guilinbai/iv-measurement/上位机/README.md

# 上位机软件（4 路 IV 测量）

> 本目录是**电脑端**软件。Arduino 固件在 `..\arduino测试\12\12.ino`。
> 当前进度：**第 3 期已完成**——三图界面（电压 / 电流 / **温度**），统一时间轴联动。
> 第 1 期：固件 v1.1 + 设备自检 + 采集核心；第 2 期：双图界面；
> 第 3 期：**TA612 温度采集 + Wanptek 电压源（MODBUS-RTU）控制**。

---

## 一、这台电脑的实测环境（已确认可用）

| 项目 | 实测结果 |
|---|---|
| Python | **3.11.9**（`C:\Users\guili\AppData\Local\Programs\Python\Python311`） |
| VISA | **NI-VISA 已装**（后端 `C:\Windows\system32\visa32.dll`） |
| pyvisa | 1.16.2 ✓ |
| pyserial / numpy / pyqtgraph / pandas / PyYAML | 均**已装** ✓ |
| **PySide6** | ❌ **未装**（界面要用，见下方安装命令） |
| Arduino IDE | 2.x（`C:\Program Files\Arduino IDE`），自带 arduino-cli 1.5.1 |

### 两台万用表（USB）

| 用途 | VISA 地址 | 序列号 | 固件 | 当前功能 |
|---|---|---|---|---|
| **测电压** | `USB0::0x05E6::0x6500::04587682::INSTR` | 04587682 | 1.7.12b | `VOLT:DC` |
| **测电流** | `USB0::0x05E6::0x6500::04468141::INSTR` | 04468141 | 1.0.04b | `CURR:DC` |

两台都在 **NPLC=1、自动调零开、电压量程 0.1 V、电流量程 10 µA** —— 正好适合小信号器件。

### 关键实测数据（决定时序参数）

| 指标 | 实测值 | 影响 |
|---|---|---|
| `:READ?` 耗时 | **约 21~25 ms**（自动量程下） | 但**自动调零每 5 次会到 43 ms**，自动量程切换时更慢 → 固件 `T_WINDOW=80 ms` 才安全 |
| 电压档本底噪声 | ±0.1 mV 波动 | 远优于 mV 级信号 ✓ |
| **电流档本底** | **±20~50 pA** | 比 10 µA 信号低 5 个数量级 ✓ 系统很干净 |
| 一轮 8 次测量 | **实测 1.80 s**（T_WINDOW=80） | 间隔 2 s 余量 **0.20 s（偏紧）**；建议 2.5 s |

### 串口

| 端口 | 设备 | 说明 |
|---|---|---|
| **COM9** | USB-SERIAL CH340 | **Arduino（开关阵列）** ✓ |
| COM11 | USB-SERIAL CH340 | 另一个 CH340 设备（不是 Arduino） |
| COM5 / COM6 | 蓝牙串口 | **不要探测**（Windows 打开会卡住，脚本已自动跳过） |
| COM1 | 主板串口 | 同上 |

> ⚠️ **CH340 没有序列号**，USB 重新插拔后端口号会反复变（实测见过 `COM7/COM9` → `COM9/COM11` → `COM12/COM13`）。
> **所以脚本里不要写死端口号**：程序会自动探测；烧录固件前也要先探测（见下方"端口总在变怎么办"）。
> 所以 `config.yaml` 里 `arduino.port` **建议留空**，由程序**自动探测**（发 PING，谁回应谁是 Arduino）。

---

## 二、安装依赖

```powershell
# 只缺界面库（其余都装好了）
pip install PySide6
```

> 如果以后换电脑，一次装齐：
> ```powershell
> pip install pyvisa pyserial numpy pandas PyYAML pyqtgraph PySide6
> ```
> 另外需装 **NI-VISA**（或 Keysight IO Libraries）才能用 USB 连万用表。

---

## 三、目录里的文件

| 文件 | 作用 | 状态 |
|---|---|---|
| `config.yaml` | 全部配置（设备地址、采样间隔、存储目录、时序参数） | ✅ 已按实测填好 |
| `check_devices.py` | **设备自检**：查两台表 + 找 Arduino + 实测耗时 | ✅ 实测 3.4 s |
| `main.py` | 采集主程序（命令行版：调度 + 双表读数 + 落盘） | ✅ 已实测跑通 |
| **`main_gui.py`** | **★ 图形界面**（双图 + 控制面板 + 实时状态） | ✅ **第 2 期** |
| `inspect_db.py` | 数据查看与筛选导出（`--runs` 看运行记录） | ✅ 可用 |
| `setup_github.py` | **一键配置 GitHub 备份**（配远程 + 测连通 + 推送） | ✅ 见 `17-备份到GitHub.md` |
| `ui/main_window.py` | 主窗口：控制区、状态栏、日志、间隔保护 | ✅ |
| `ui/plots.py` | 双图组件：X 轴联动、时间轴、降采样 | ✅ |
| `ui/buffer.py` | 内存环形缓冲 + 降采样 + 跨天历史查询 | ✅ |
| `ui/worker.py` | 采集线程（信号驱动，界面永不被阻塞）+ 模拟数据源 | ✅ |
| `ivcore/config.py` | 配置加载 + 一轮耗时/间隔保护计算 | ✅ |
| `ivcore/devices.py` | 硬件封装（Arduino 串口自动探测 + DMM6500） | ✅ |
| `ivcore/storage.py` | 存储（SQLite WAL + CSV 实时副本 + 分钟/小时聚合表） | ✅ |
| `ivcore/scheduler.py` | 采集调度（发 S → 收 WIN → 读表 → 落盘）+ 降采样 | ✅ |

---

## 四、使用步骤

### 第 1 步：上传 Arduino 固件 v1.1（[OK] 已完成，2026-10-30）

用 Arduino IDE 打开 `..\arduino测试\12\12.ino` 上传（板子选 **Arduino Nano**、处理器 **ATmega328P**、端口 **COM9**）。

> ⚠️ **上传前必须先关掉串口监视器**，否则报"拒绝访问"。

v1.1 相比 v1.0 新增：
- `S` 命令：扫一轮（4 路 × V+I = 8 项，按模式分组，耦合器只切 2 次）
- 每个读数窗口上报 `WIN <通道> <V|I>`（PC 收到立刻读表）
- 一轮结束报 `ROUND DONE`
- **看门狗**：10 秒没收到命令自动回安全态并报 `WATCHDOG`

### 第 2 步：跑设备自检

```powershell
cd D:\Ai_agent\deepseek-ha\test-system\上位机
python check_devices.py
```

正常输出应包含：两台 DMM6500、Arduino 在 COMxx、以及一轮耗时建议。

也可以分开查：

```powershell
python check_devices.py --idn      # 只查万用表
python check_devices.py --serial   # 只查串口
```

### 第 3 步：跑采集主程序（第 1 期核心）

> ⚠️ **运行前先关掉 Arduino IDE 的串口监视器**，否则报"打不开串口 COM9"。

```powershell
cd D:\Ai_agent\deepseek-ha\test-system\上位机

python main.py                 # 按 config.yaml 一直跑（Ctrl+C 停止）
python main.py --rounds 5      # 只跑 5 轮（先验证）
python main.py --duration 60   # 跑 60 秒
python main.py --interval 3    # 临时改成 3 秒间隔
python main.py --no-csv        # 不写 CSV 实时副本
python main.py --dry           # 不连硬件，用假数据验证存储链路
```

正常输出（实测）：

```
  [    1]  8/8  14:23:37 | lag -0.36s | V: -0.035 mV -0.065 mV 0.011 mV 0.041 mV   I: 0.06 nA 0.02 nA -0.04 nA 0.02 nA
  [    2]  8/8  14:23:39 | lag -0.42s | V: 0.057 mV 0.098 mV 0.037 mV 0.125 mV    I: 0.04 nA 0.03 nA 0.08 nA 0.02 nA
```

| 字段 | 含义 |
|---|---|
| `8/8` | 本轮采到的项数 / 应有项数 |
| `lag -0.36s` | 提前 0.36 s 完成（**负数=有余量**；变正数说明跟不上） |
| `V: ...` `I: ...` | 4 路电压 / 4 路电流的读数 |
| 收尾时 `[OK] 一致（N 行）` | CSV 实时副本与数据库行数一致（关闭时自动校验补齐） |

### 第 4 步：查看 / 导出数据

```powershell
python inspect_db.py                                  # 看最新一天的概况
python inspect_db.py --list                           # 列出所有天的数据库
python inspect_db.py --runs                           # ★ 看 runs 表（每次运行的时间 + 配置快照）
python inspect_db.py --export out.csv --ch 1,3 --mode V   # ★ 空通道在这里一次筛掉
python inspect_db.py --export wide.csv --wide         # 宽表（一行一轮，与实时副本同格式）
python inspect_db.py --export p.csv --from 14:00 --to 15:00
```

`--runs` 输出示例（能看到每次运行到底用了什么配置）：

```
  run_id = 3
     开始 : 2026-10-12 15:58:31
     结束 : 2026-10-12 15:58:42
     时长 : 10.6 秒
     配置 : 间隔=2.0 s   通道=4   T_WINDOW=50 ms
            dmm_voltage = USB0::0x05E6::0x6500::04587682::INSTR
            dmm_current = USB0::0x05E6::0x6500::04468141::INSTR
            存储目录: D:\IV_data
            本次命令行覆盖: {'rounds': 2}
            程序: main.py (CLI, phase-1)
```

也可以直接用图形工具打开数据库（推荐免费的 **DB Browser for SQLite**，官网 `sqlitebrowser.org`）：
打开 `D:\IV_data\2026-10-12\2026-10-12.db` → 选 **Browse Data** → 下拉框切表（`samples` / `runs` / `round_log` / `events` / `agg_1min` / `agg_1hour`）。

### 第 5 步：启动图形界面（第 2 期）

> ⚠️ 同样：**先关掉 Arduino IDE 的串口监视器**。

```powershell
python main_gui.py                 # 正常启动
python main_gui.py --fake          # 启动即进入模拟模式（不接硬件，看界面效果）
python main_gui.py --interval 5    # 覆盖采样间隔
```

界面布局与操作：

```
┌ [▶开始采集] [■停止] │ 采样间隔[2.00 s] │ 视图 (10分)(1时)(1天)(7天) │ [✓]跟随最新 │
│ 通道 [✓]ch1 [✓]ch2 [✓]ch3 [✓]ch4                              [ ]模拟模式 ┐
├ ✓ 一轮耗时 1.80 s ／ 间隔 2.50 s ／ 余量 0.70 s —— 可行                    ┤
│  电压 Voc（上）  ┐                                                         │
│                  ├ ← 两个图 X 轴联动（缩放/平移任一个，另一个同步）        │
│  电流 Isc（下）  ┘                                                         │
├ 状态：轮数/周期/余量/点数/时长/数据来源   │ 日志：连接、探测、事件        │
└────────────────────────────────────────────────────────────────────────────┘
```

| 功能 | 说明 |
|---|---|
| **双图共享时间轴** | 上图电压、下图电流；缩放/平移任意一个，另一个同步（垂直网格线始终对齐） |
| **四档视图** | 10 分钟 / 1 小时 → 内存缓冲；1 天 → `agg_1min`；7 天 → `agg_1hour`（秒出） |
| **跟随最新** | 自动滚动到最新；你一旦手动缩放/平移，会**自动取消跟随**（避免打架） |
| **通道开关** | 取消勾选即隐藏某路曲线（**不影响采集与存储**）—— 空通道的噪声点一下就没 |
| **间隔保护** | 实时计算"一轮耗时/间隔/余量"，不够时**红字警告** |
| **模拟模式** | 不连硬件生成假数据，用来预览界面、验证绘图性能。**注意：模拟模式只喂给界面看，不写数据库**（避免假数据混进真实数据） |
| **优雅退出** | 关窗时先让采集线程收尾（Arduino 回安全态 → 校验 CSV），最多等 15 秒 |

**实测性能**（这台电脑）：

| 指标 | 结果 |
|---|---|
| 降采样 100 万点 → 1600 点 | **18.6 ms** ← 绘图耗时与数据量无关的数学保证 |
| 界面刷新 | 3 Hz（可改 `ui.refresh_hz`） |
| 7 天视图查询 | 走 `agg_1hour` 只取约 168 点 → **毫秒级** |

自检用的无头截图模式（不需要显示器）：

```powershell
python main_gui.py --fake --screenshot preview.png --shot-seconds 25
```

---

## 五、config.yaml 怎么改

| 想要什么 | 改哪里 |
|---|---|
| 换数据存放位置 | `storage.dir` |
| 改采样间隔 | `acquisition.interval_s`（**最小 2.16 s** 比较稳；2.0 s 也行但余量只有 0.20 s） |
| 关闭"边测边写 CSV" | `storage.write_csv_realtime: false`（不推荐，会失去断电保护） |
| 手动指定 Arduino 端口 | `devices.arduino.port: ""`（**建议留空自动探测**，见下方"端口总在变"） |
| 调整读数精度/速度 | `devices.dmm_*.nplc`（小信号建议保持 1） |
| **量程策略** | `devices.dmm_*.autorange`（**默认 true = 自动量程**，见下方） |

### ⚠️ 量程策略（重要：不要锁死量程）

| 配置 | 行为 | 什么时候用 |
|---|---|---|
| **`autorange: true`（默认）** | 表自己选档位 | ✅ **正常用这个** |
| `autorange: false` + `range: 0.1` | 锁死在 100 mV 档 | ⚠️ **只有确认被测值一定在该档内**才用 |

**为什么不能锁死**：把电压表锁在 0.1 V 档后，一旦器件 Voc 超过 0.1 V（比如 1.5 V）就**超量程报错**，读数无效。电流表锁在 10 µA 档同理。

**自动量程的两个实测特性**（我已验证并据此调整参数）：

| 特性 | 实测 | 应对 |
|---|---|---|
| 信号稳定时**不切换档位** | 每次读数仍只要 21~25 ms | 无需额外代价 ✓ |
| **自动调零（AZER）每 5 次**多花约 20 ms | 周期性出现 41~43 ms | 固件 `T_WINDOW` 从 50 → **80 ms** |
| 量程切换时那一次较慢 | 可能 60~100 ms | **启动时预热 3 次**让档位先稳定（程序已自动做） |

日志里会显示实际量程，例如：
```
电压表: 已配置 func=VOLT:DC 量程=0.1(自动)
电压表: 预热 3 次，量程=0.1(自动)，单次 21~23 ms
```

### ⚠️ 间隔保护（程序会提示）

| 采样间隔 | 一轮 1.80 s 之后的余量 |
|---|---|
| **2.5 s（推荐）** | 0.70 s ✓ 舒服 |
| 2.0 s（你当前的设定） | **0.20 s** ⚠️ 可行但偏紧 |
| 1.8 s | ~0 s ✗ 临界 |
| < 1.8 s | 负 ✗ 跑不完 |
| **最小建议** | **2.16 s**（= 1.80 × 1.2） |

**想用 2.0 s 又想要更多余量**：把 `config.yaml` 的 `t_settle_ms` 从 80 降到 60（同时固件里 `T_SETTLE` 也要改并重新上传），一轮就降到 1.64 s，余量变 0.36 s。

程序会在间隔过小时红字警告（命令行/界面都会）。

---

## 六、常见问题

| 现象 | 原因 / 解决 |
|---|---|
| `[X] 打开 VISA 失败` | NI-VISA 没装，或万用表被其它软件占用（KickStart 等） |
| 只找到 1 台表 | 检查另一台 USB 是否插好；两台表的 USB 线别插在同一个 Hub 上尝试换口 |
| 串口无回应 | ① Arduino 被 IDE 的串口监视器占用 → 关掉；② 数据线是"只能充电"的线；③ 板子没插好 |
| 脚本输出中文乱码 | 用 **Windows Terminal** 或 **VS Code** 的终端运行；或在 cmd 里先执行 `chcp 65001` |
| 探测串口卡住很久 | 已修复：脚本现在**只探测 USB 串口芯片**，自动跳过蓝牙/主板串口 |
| **端口号又变了（如 COM9 → COM12）** | USB 重新枚举，CH340 端口号会变。**程序会自动探测，不用管**；但烧录固件时要先探测（见下） |

### 端口总在变怎么办（烧录固件时）

`arduino-cli` 需要显式指定端口，所以**不能写死**。先探测哪个口回应 PING：

```powershell
cd D:\Ai_agent\deepseek-ha\test-system\上位机
python check_devices.py --serial     # 会打印出"Arduino 在 COMxx"
```

然后烧录（把 `COMxx` 换成上面查到的）：

```powershell
& "C:\Program Files\Arduino IDE\resources\app\lib\backend\resources\arduino-cli.exe" `
    upload -p COMxx --fqbn arduino:avr:nano "D:\Ai_agent\deepseek-ha\test-system\arduino测试\12"
```

或者用 Arduino IDE 图形界面：**工具 → 端口** 里选那个 `COMxx` 再点上传。

> 💡 **想减少端口变化**：把 Nano 插到**主板后置 USB 口**（不要用 Hub、不要用前面板延长线）。实测插 Hub 上容易反复重编号。
| 上传固件报"拒绝访问" | 串口监视器占用 → 关掉再上传 |

---

## 八、第 3 期新增：温度采集与电压源控制

### 8.1 温度采集器（TA612，COM4）

**协议**（来自《TA系列通讯协议.docx》，已用真机 TA612 V3.50 验证）：

| 项 | 内容 |
|---|---|
| 串口 | 9600, 8N1 |
| 取型号/版本 | 发 `AA 55 00 03 02` → 回 `55 AA 00 07 64 02 5E 01 CB`（型号 0x0264=TA612，版本 V3.50） |
| 取实时温度 | 发 `AA 55 01 03 03` → 回 `55 AA 01 0B | ch1 | ch2 | ch3 | ch4 | Sum` |
| 数据换算 | 16bit 低字节在前，**温度 = 原始值 / 10**（℃） |
| 校验 | 从帧头起累加取低 8 位 |

实测：ch1 = ch2 = 26.7 ℃，**ch3/ch4 返回 28000**（未接探头的标志值，程序已自动过滤为 None）。
采集节奏独立于测量（`devices.tasensor.interval_s`，默认 5 秒）。

### 8.2 电压源（Wanptek，COM13，MODBUS-RTU）

**协议**（来自《通讯协议4_1.pdf》）：8N1、**波特率 2400**、**从站地址 0**（都是出厂默认）、数据小端、CRC16-MODBUS。

| 操作 | MODBUS 指令 | 地址 |
|---|---|---|
| 读状态/电压/电流 | `0x03` 读寄存器 | 0x0000 状态0, 0x0001 状态1, 0x0002 当前电压, 0x0003 当前电流, 0x0004 设置电压, 0x0005 设置电流, 0x0006 最大电压, 0x0007 最大电流 |
| 设电压 | `0x10` 写寄存器 | **0x0001**（值 = 电压 × 100） |
| 设限流 | `0x10` 写寄存器 | **0x0002**（值 = 电流 × 1000） |
| 输出开关 | `0x05` 写线圈 | **0x0000**（0xFF00=开 / 0x0000=关） |

实测本机电源：**31 V / 5.2 A**，初值 设定 10.690 V / 1.000 A、输出已开。

> ⚠️ **之前探测失败的原因**：我一直试 9600 bps + 地址 1，而设备默认是 **2400 bps + 地址 0**。
> 如果换电源，用 `python -m ivcore.powersupply COM13` 只读自测（不会改任何设置）。

**安全设计**：
- 超过设备最大电压（31 V）直接拒绝
- 退出程序**默认不关输出**（`off_on_exit: false`），避免打断控温实验
- 界面操作：`驱动电压源：[10.69] V  [应用]  [输出：开/关]  实测 0.000V/0.000A 设定 10.69V/1.000A 恒压`

### 8.3 界面：三个图共享时间轴

`
┌ 电压 Voc   4 条曲线 ┐
├ 电流 Isc   4 条曲线 ┤ ← X 轴联动（缩放/平移任一个，其余同步）
├ 温度 ℃     T1、T2   ┘   ch1 红 / ch2 蓝；两条线的**间距就是 ΔT**
`
状态栏还会直接显示 `T1=26.7  T2=26.7  ΔT=0.0 ℃`。
**温差会随驱动电压增大而拉大** —— 图上看两条线的间距即可。

### 8.4 数据文件新增

同一天目录下多一个 **`YYYY-MM-DD_env.csv`**（一行一次温度采样）：

`csv
iso_time,t1,t2,dt
2026-10-21 16:54:08,26.70,26.70,0.00
2026-10-21 16:54:13,26.80,26.60,0.20
`
- `t1`/`t2` = ch1/ch2 温度（℃）
- `dt` = **温差**（自动计算）
- 对应数据库表 `env(ts, run_id, sensor, ch, value, unit, quality)`
- 时间戳用 PC 时间（设备帧里没有时间戳），所以与测量数据天然共轴 ✅

---

## 七、数据格式（重要）

### 7.1 CSV 实时副本：**宽表，一行一轮**

```csv
iso_time,round_id,v1,i1,v2,i2,v3,i3,v4,i4
2026-10-12 15:56:25,1,-7.17045e-05,6.56688e-12,-0.000529928,-8.68163e-12,-0.00138152,5.5831e-12,-0.000532182,2.69802e-11
2026-10-12 15:56:27,2,3.11824e-05,7.62438e-12,-4.82313e-05,7.67346e-11,-3.42538e-05,4.9773e-11,1.07207e-06,2.92067e-12
2026-10-12 15:56:29,3,-6.8232e-05,...
```

| 列 | 含义 | 说明 |
|---|---|---|
| **iso_time** | 本轮的**网格时刻** | **只到秒**；**严格按采样间隔递增**（设 2 s 就每行差 2 s，设 5 s 就差 5 s）。它是 `t0 + n × 间隔` 算出来的，所以永不断档、永不等间隔失真 |
| **round_id** | 轮号 | 在**同一天内连续递增**，程序重启也不会重置 → 重启后的数据仍能按它排序 |
| **v1,i1,v2,i2,v3,i3,v4,i4** | 4 路的电压/电流 | 某路读失败 → 该格**留空**（不写 0，避免误判）；整轮失败 → 写一行空数据，**保证时间列不断档** |

> 💡 **时间列的两种含义**（都在 SQLite 里，溯源时可查）：
> - `iso_time`（CSV 里这一列）= **本轮网格时刻**，代表"这一轮是什么时候测的"，等间隔
> - `samples.ts`（只在数据库里）= 每个测量点的**物理精确时刻**，8 个点相差约 190 ms
>
> 你的器件在 7 天尺度上变化很慢，用网格时刻画图完全够，而且横轴天然均匀。

### 7.2 数据库里另外两列的含义（CSV 里没有，供追溯）

| 列 | 含义 | 用途 |
|---|---|---|
| **run_id** | 第几次"运行会话"——每启动一次 `main.py` 就是一个 run（1,2,3…） | 区分"这批数据是哪次连续采集的"；`runs` 表里还存了每 run 的**起止时间**和**当时的完整配置**（`config_json`），半年后能回答"当时参数是多少" |
| **quality** | 数据质量：`0`正常 / `1`可疑 / `2`无效 | 目前读数失败会记 `2`；后处理可 `WHERE quality=0` 一次滤掉坏点 |

### 7.3 存储结构

```
D:\IV_data\
└─ 2026-10-12\
   ├─ 2026-10-12.db              主存储（SQLite，WAL）
   │     samples    每个测量点一行（含精确 ts、grid_ts、run_id、quality）
   │     round_log  每轮一行（含空轮）→ 宽表可完整重建
   │     runs       每次运行的起止时间与配置快照
   │     events     事件日志（断线、重连、网格重对齐等）
   │     agg_1min / agg_1hour   多分辨率聚合表（画 1 天 / 7 天视图用）
   └─ 2026-10-12_samples.csv     实时副本（宽表，一行一轮）
```

- **命名零填充**（`2026-10-03` 而不是 `2026-10-3`）→ 按文件名排序 = 按时间排序 ✓
- **WAL 模式** → 断电不损坏，最多丢 1~2 秒
- **7 天数据量**：约 30 万行 / **~15 MB**（2 s 间隔、含温湿度；比长表省很多）
- **画图不卡**：多分辨率聚合表 + 按像素降采样 → 绘图耗时只跟屏幕宽度有关，与数据量无关

> ⚠️ **格式变过一次**：如果你的目录里有早期版本生成的 CSV（长表、毫秒时间戳），
> 建议删掉那个文件重跑 —— 新旧格式混在一个文件里会乱。
> 数据库会自动迁移（补 `grid_ts` 列），不用管。
> 第一次git修改尝试ing
