guilinbai/iv-measurement/1-测试系统目的与设计.md

# 多路并行 IV 测量系统 · 项目说明（文件一）

> **一句话**：用一台 Keithley DMM6500，轮询测量 16 路（可扩展）**彼此独立、浮空**的器件，记录每路的 **开路电压 Voc** 与 **短路电流 Isc**，连续运行 ≥7 天无人值守。
>
> **本包共 12 项（9 份文档 + 1 个固件 + 2 张图，图各含 svg/png）**：①本说明 ②CircuitJS 仿真·手动版（2 路教学） ③CircuitJS 仿真·Arduino 自动版（**4 路**） ④采购清单 ⑤面包板排线教程（14 只光耦逐脚接线表） ⑥单通道接线详图（svg+png） ⑦系统整体结构图（svg+png） ⑧面包板接线图画法（用 Fritzing 画实物接线图） ⑨PCB打板与四路板设计（含网表与布局图） ⑩四路板PCB布局图 ⑪Arduino入门与固件编写 ⑫固件-4路IV测量.ino

---

## 1. 目标与需求基线

| 项 | 指标 |
|---|---|
| 通道数 | 16 路起（PCB 与 595 链预留，可扩到 24/32） |
| 测量内容 | 每路 **Voc** 与 **Isc**，可选二选一或都测 |
| 器件量程 | Voc ≤ **2 V**（含小信号 **100 mV** 场景）；Isc ≤ **10 mA**（含 **10 µA** 场景） |
| 器件特性 | 彼此**独立、浮空**；允许长期短路、允许开路，不会损坏 |
| 连续运行 | **≥ 7 天**无人值守 |
| 采样间隔 | 几百 ms ~ 几百 s 任意可配 |
| 引线长度 | 器件 → 开关阵列 **≤ 1 m** |
| 预算 | 开关/继电器部分 **≤ 1000 元** |
| 装配约束 | **不会焊接** → 两阶段：面包板（直插） → 嘉立创 PCB + SMT 代贴 |
| 接线制式 | **两线制**（不用四线/开尔文）；汇总式**轮询**（非真并行） |
| 温度预留 | 本期不装，只留 4 针槽位（5V/GND/SDA/SCL + A0/A1） |

---

## 2. 测试逻辑（核心，不能做错的部分）

### 2.1 每个通道 3 只开关

器件两端各一只"选通开关"接到公共母线，另有一只"短接开关"直接并在器件两端：

```
   器件 A 端 ──┬──[ R_selA 选通 ]── 母线 HI ──┬──[ 模式耦合器 A ]── DMM 电流端口 ─┐
               │                              ├──[ 模式耦合器 V ]── DMM 电压端口 ─┤
               └──[ R_short 短接 ]──┐         │                                  │
                                    │         │                          DMM 公共端(黑)
   器件 B 端 ──┬─────────────────────┘         │                                  │
               └──[ R_selB 选通 ]── 母线 LO ───┴──────────────────────────────────┘

   · R_short 并在器件的 A、B 两端之间：闭合 = 器件被硬短接（0 V 工作点）
   · R_selA / R_selB 决定该器件是否接入母线 → 未选中器件与母线完全隔离
   · 全部开关用常开型 PhotoMOS（AQY272 / AQY212EH / AQY221R2V），LED 亮 = 导通，静音、长寿命
```

**为什么 B 侧开关不能省**：省掉 R_selB（让它常闭）就等于把 16 个器件的 B 端全部硬连在母线 LO 上——器件不再隔离。后果：①串扰漏电翻倍（未选中通道的漏电通路从 `2·R_off` 降到 `1·R_off`）；②16 路共地引入地环流与天线效应；③失去"A、B 双开关串联把关"的故障容错（R_selA 一旦短路失效，该器件会永久并联在母线上且无迹象）。只有"器件本来就共负端"时才可改单端复用（每通道 1 只开关）。

### 2.2 通道状态表

| 模式 | 状态 | 选通 A/B | 短接 | 器件看到什么 |
|---|---|---|---|---|
| Isc | 间隙 | 断开 | **导通** | 两端硬短接 |
| Isc | 过渡①：先断短接 | 断开 | 断开 | **开路**（升到 Voc） |
| Isc | 取样 | **导通** | 断开 | 电流表（近零 burden） |
| Isc | 过渡②：先离表 | 断开 | 断开 | **开路** |
| Voc | 间隙 / 取样前 | 断开 | 断开 | 开路 |
| Voc | 取样 | **导通** | 断开 | 电压表（高阻） |
| **安全态（上电/掉线/看门狗）** | — | 断开 | **导通** | 隔离 + 短接 |
| 整机掉电 | — | 断开 | 断开 | 开路（无驱动） |

### 2.3 切换时序：**先断短接，再合选通**（break-before-make）

```
测 Isc(ch)：                                   测 Voc(ch)：
 ① 断开短接（器件开路 → Voc）                   ① 断开短接（确保不短接）
 ② 等待 t_open（10~50 ms）                      ② 等待 t_open
 ③ 合选通 A/B（接入电流表）                     ③ 合选通 A/B（接入电压表）
 ④ 等待 settle_time（★50~100 ms）               ④ 等待 settle_time
 ⑤ 读 Isc                                       ⑤ 读 Voc
 ⑥ 断选通 A/B（先离表）                         ⑥ 断选通 A/B
 ⑦ 等待 t_open                                  ⑦ 合短接（回间隙态）
 ⑧ 合短接（回间隙态）
```

**为什么这样**：任何时刻"短接通路"与"测量通路"**绝不同时导通** → 表计读到的电流**不含分流成分**，是器件完整的 Isc（原"先合后断"方案会有短接开关并联分流的瞬间）。

**代价与配套**：器件接表前后各有一次短暂开路，接表瞬间有放电瞬态（τ ≈ R_burden × C_器件）→ `settle_time` 取 **50~100 ms** 起步，按器件电容实测缩短。前提是器件允许开路。

### 2.4 三条关键电气约定

1. **未选中通道保持短接（钳位 0 V）**：这是抑制串扰的关键——器件被短接后 Voc 被钳到 0 V，不再向母线注入电压，串扰只剩纯漏电阻分流。任何时刻只有被选中通道的短接开关断开。
2. **表 burden 要小**：burden 是漏电误差的乘数。用 DMM6500 低电流量程（反馈式电流计）；若要把 10 µA 测得更准，可加一级跨阻放大器（TIA，虚地 → 漏电影响趋近 0）。
3. **漏电门槛**（针对小信号器件，详见 2.5）：**直插型号 ≥60 MΩ（≤1 µA @60 V）刚好达标；推荐 ≥600 MΩ（≤100 nA）**。

### 2.5 漏电流预算速查（小信号器件的选型依据）

**先折算再比较**——datasheet 漏电是在**额定电压**下规定的：

```
AQY272：10 µA @ 60 V  →  R_off = 60 V ÷ 10 µA = 6 MΩ
器件工作电压只有 100 mV →  实际漏电 = 100 mV ÷ 6 MΩ ≈ 17 nA（不是 10 µA！）
器件模型：Rs = Voc ÷ Isc = 100 mV ÷ 10 µA = 10 kΩ
```

| 误差来源（N=16，15 路未选中） | 公式 | AQY272(6 MΩ) | AQY212EH(60 MΩ) |
|---|---|---|---|
| 短接开关漏电并在器件两端（测 Voc） | Voc·Rs/(Rs+R_off) | −1.7% | **−0.17%** |
| 短接开关漏电分走 Isc（burden 10 mV） | V_b/R_off | 1.7 nA | **0.17 nA** |
| 未选中通道短接时的串扰（burden 100 mV） | V_b(N−1)/(2R_off) | 1.25% | **0.125%** |
| 未选中通道开路时注入 Voc 差（ΔVoc=100 mV） | ΔVoc·Rs/(Rs+2R_off/(N−1)) | 1.23% | **0.125%** |

**反推门槛**（目标：漏电误差 ≤ 0.1% × 10 µA = 10 nA）：`R_off ≥ 7.5×10⁸ × V_b`
→ burden 10 mV 需 ≥7.5 MΩ；burden 100 mV 需 ≥75 MΩ。
→ **门槛 ≤1 µA @60 V，推荐 ≤100 nA**（留 10 倍余量）。

> 注意：PhotoMOS 关断漏电**随温度上升**（可能翻数倍）。7 天连续测试要按最高工作温度算。

---

## 3. 测试模式与调度

| 模式 | 行为 | 表功能切换 |
|---|---|---|
| `isc_only` | 每轮只测 Isc | 一次都不用切 |
| `voc_only` | 每轮只测 Voc | 一次都不用切 |
| `both` | 每轮先 Isc 后 Voc（同一通道连测），或按轮次交替 | 每通道切一次，需等表稳定 |

**调度规则**：
- 一轮扫描 = 依次测完所有**启用**的通道；**整轮间隔**由一个共用计时器控制（启用 4 路就扫 4 路，间隔仍是设定值）；
- 相邻两路取样窗口**不重叠**（同一时刻只有一个器件接在母线上）；
- `both` 模式的**轮间间隙态 = 短接**（不长期开路）；
- 采样间隔可配：几百 ms ~ 几百 s。

**模式切换顺序**（`both` 模式或分时段计划，整轮层面执行一次）：
① 所有通道回间隙态 → ② 先断当前模式耦合器 → ③ 切 DMM 功能（`SENS:FUNC "CURR"`/`"VOLT"`）+ 量程/NPLC → ④ 再合新耦合器 → ⑤ 等 50~100 ms → 继续扫描。

---

## 4. 硬件方式

### 4.1 总体架构

```
 ┌── 被测器件 1..16（彼此独立、浮空，两线引出，双绞线 ≤1 m）──┐
 │                                                              │
 │   每通道 3 只常开 PhotoMOS（2 选通 + 1 短接）                │
 │        ↑ LED 驱动（各串 1 kΩ 限流电阻）                      │
 └────────┴─────────────────────────────────────────────────────┘
          │
 ┌────────┴─────────┐
 │ 控制链（与测量侧光学隔离，不共地）                        │
 │  Arduino Nano ── SPI(3 线) ── 74HC595 ×4（32 位锁存）     │
 │  每通道 2 位：选通位（驱动 A、B 两只）、短接位             │
 │  串口 115200 接 PC；看门狗 10 s 无指令 → 写入安全态       │
 └──────────────────┘
          │
 ┌────────┴─────────┐
 │ 测量侧（浮空，不接控制地）                                │
 │  母线 HI ──┬─ 模式耦合器 A ── DMM 电流端口（1 Ω 级 burden）│
 │            └─ 模式耦合器 V ── DMM 电压端口（≥10 GΩ）      │
 │  母线 LO ─────────────────── DMM 公共端（黑，INPUT LO）   │
 └──────────────────┘
```

### 4.2 控制链要点

- **每通道 2 个控制位**：选通位（同时驱动 A、B 两只光耦的 LED，各串 1 kΩ）、短接位；
- **4 路原型**：Nano 直驱 → 用 **D2~D11 共 10 个数字输出**（4 路 × 2 位 + 2 只模式耦合器），不需要 595；完整逐脚接线见《5-面包板排线教程.md》；
- **16 路正式板**：32 位 → **4 片 74HC595 级联，只占 3 个引脚**（`D10`=数据 DS、`D11`=移位时钟 SHCP、`D12`=锁存 STCP）。若直驱则需 32 个引脚，而 Nano 可用数字输出只有 16 个（D2~D13 + A0~A3）→ **不够，必须用 595**；
- ⚠️ **引脚坑**：`A6/A7` **只能作模拟输入**，不能配置为数字输出 → 不可用于驱动光耦 LED；`D0/D1` 留给串口；`A4/A5` 预留给温度（I2C）；
- **固件原子执行整段时序**：PC 只发高层命令（`PING / ALL_SAFE / MEAS ch mode / RESTORE ch mode / READBACK`），不逐位控制，防止 PC 卡顿导致器件悬空；
- **看门狗 10 s**：无指令 → 写入安全态（选通全断、短接全合）；
- 上电第一条指令即写入安全态；整机掉电时 595 无输出 → 全断开 = 器件开路（已接受此代价）；
- 电源：5 V/1 A 适配器；48 只 LED 全亮约 144 mA + Nano 30 mA，裕量充足。

### 4.3 万用表三端口与模式耦合器

| DMM 端子 | 接法 |
|---|---|
| **公共端（黑，INPUT LO）** | 母线 LO（电流档与电压档**共用**） |
| **电流端口** | 经**模式耦合器 A** 接母线 HI |
| **电压端口** | 经**模式耦合器 V** 接母线 HI |

> ⚠️ **互锁必做**：两个模式耦合器**绝不可同时闭合**（电流端口约 1 Ω 会把电压端口旁路，电压读数立即失效）。**推荐一只 SPDT 耦合器**（公共端接母线 HI、两掷位分别接电流/电压端口），物理上不可能同时接通；若用两只独立开关，必须固件互锁 + 硬件联锁。

### 4.4 两阶段实施

| 阶段 | 做法 | 目的 |
|---|---|---|
| ① 面包板（4 路） | 直插 **AQY212EH ×14**（12 通道 + 2 模式耦合器）+ Arduino Nano + 面包板 ×3，**零焊接**；逐脚接线见《5-面包板排线教程.md》 | 验证时序、固件、上位机流程与接线 |
| ② 正式板（16 路） | 嘉立创 PCB 打样 + SMT 代贴 AQY221R2V ×48 + 排母插 Nano | 小信号精度、7 天连续运行 |

### 4.5 接线与屏蔽

- 器件 → 开关 ≤1 m：**24 AWG 双绞线**（或网线成对取用），A 端红、B 端黑，每通道挂线标；
- 开关 → DMM：母线两线双绞引出；
- 端子排按 ch1→ch16 排列（左 A 右 B，防插错）；
- ≤1 m 下无需屏蔽；有强干扰源时母线改屏蔽双绞线，屏蔽层浮接 DMM 大地端子。

---

## 5. 已定决策与陷阱速查

### 5.1 已定决策

| 议题 | 结论 |
|---|---|
| 开关类型 | 全 **常开 PhotoMOS**（全固态、静音、统一型号），短接靠**主动驱动** |
| 间隙态 | Isc 模式 = **短接**（兼作串扰钳位）；Voc 间隙 = 开路 |
| 切换顺序 | **先断短接 → 再合选通**（break-before-make） |
| 掉电行为 | 开路（不再"掉电即短接"，已接受） |
| 故障安全 | **固件看门狗主动维持短接态**（必须做） |
| 接线制式 | 两线制；轮询；不用四线/开尔文 |
| 器件短路 | 可长期短路不受损 → 无需常态化短接 |

### 5.2 陷阱速查（都踩过）

| # | 陷阱 | 要点 |
|---|---|---|
| 1 | **AQY212EH vs AQY212EHA** | Package 都写 DIP4，但 `EHA` 是**贴片鸥翼**；**不带 A 后缀的 `EH` 才是直插**。下单前看手册 "Terminal Type" |
| 2 | **低漏电只有贴片** | nA 级（RF/低 C×R 系列）只有 SSOP/SOP；直插 DIP-4 通用型是 µA 级（1 µA） |
| 3 | **漏电不能直接比** | datasheet 漏电在额定电压下规定，要按实际工作电压折算（见 2.5） |
| 4 | **两个模式耦合器同时闭合** | 1 Ω 旁路 10 MΩ → 电压读数失效；用 SPDT 或做互锁 |
| 5 | **CircuitJS：控制端位置** | 模拟开关控制端由"**吸附到网格后的引线中点**"算出 → **元件中点必须落在 16 的整数倍上**，否则控制线接不上（表现为 `bad connections`、开关恒断开） |
| 6 | **CircuitJS：电压源极性** | **第 2 个点才是正端**（`getVoltageDiff()` = volts[1]−volts[0]）；接反了控制端会变成 0/−5 V，低于 2.5 V 阈值 → 开关永不导通 |
| 7 | **B 侧开关不能省** | 见 2.1（串扰翻倍、共地环流、失去故障容错） |

---

## 6. 本包使用方法

### 6.0 先看两张图（比文字快）

| 图纸 | 看什么 | 格式 |
|---|---|---|
| **6-单通道接线详图** | 一个通道怎么接：**1kΩ 限流电阻接在光耦 1 脚与 Arduino 引脚之间**、2 脚接控制侧 GND、3/4 脚接器件与母线；以及"为什么仿真图里看不到 1kΩ" | `.svg`（矢量，可无限放大）+ `.png`（直接看） |
| **7-系统整体结构图** | 4 路整体结构：14 只光耦的分工（通道1~4 + 模式耦合器）、母线 HI/LO 的汇集、模式耦合器与万用表三端口、控制侧与测量侧的隔离边界 | `.svg` + `.png` |

> ⚠️ **仿真图与真实电路的一处重要差异**：CircuitJS 的"模拟开关"是**理想电压控制开关**（控制端只判电压、不耗电流），所以仿真里**画不出 LED 侧**，也就没有 14 只 1kΩ 限流电阻。真实电路必须有（每只光耦 1 脚各一只），详见第 6 图。

### 6.1 打开仿真文件（文件二 / 文件三）

1. 浏览器打开 **https://www.falstad.com/circuit/circuitjs.html**
2. 菜单 **File → Import From Text**，把 `.txt` 全部内容粘进去，确定
3. 点 **RUN** 开始仿真；`View → Zoom Out` 可看全图（4 路版图较高，需多缩几档）
4. 读电流：鼠标**停在 1 Ω 取样电阻上不动**，信息框显示 `I`

| 文件 | 特点 |
|---|---|
| **文件二（手动版）** | **2 个器件**、手动开关（教学用，开关少好操作），用来**看懂"先断短接→再合选通"的顺序** |
| **文件三（Arduino 自动版）** | **4 路**，周期 1 秒、每路一个 250 ms 时间槽；8 个方波源模拟 D2~D9 引脚输出，自动循环；含万用表三端口与两个模式耦合器（手动开关） |

### 6.2 文件三的操作要点

- **4 路时间槽**：ch1 `[0~0.25s]`、ch2 `[0.25~0.5s]`、ch3 `[0.5~0.75s]`、ch4 `[0.75~1.0s]`，每路测量窗口 **125 ms**，互不重叠；
- 各通道器件模型不同（便于区分读数）：ch1 = 1.5 V/150 Ω（≈9.9 mA）、ch2 = 1.2 V/240 Ω（≈5.0 mA）、ch3 = 1.0 V/100 Ω（≈9.8 mA）、ch4 = 0.6 V/300 Ω（≈2.0 mA）；
- 默认状态 = **电流模式**（模式耦合器 A 闭合、V 断开）→ 悬停 1 Ω 看 Isc；
- 测 **Voc**：**先点开**模式耦合器 A，**再点合**模式耦合器 V → 悬停 10 MΩ 看电压；
- 验证"信号纯净"：悬停各开关，会发现**没有任何时刻"选通=闭合"且"短接=闭合"**；
- 图上标注的 **光耦1 ~ 光耦14** 与《5-面包板排线教程.md》的编号**完全一致**，可对照验证接线。

### 6.3 下一步

1. 面包板按阶段①搭起来，跑通固件 + 上位机流程；
2. 用 DMM6500 **实测**关断漏电（加 100 mV、LED 不加电、电流档串测）→ 用它校正 2.5 的预算；
3. 固件把 2.3 的时序表实现为状态机；上位机按 3 的模式与调度写采集循环；
4. 正式板 layout（16 路 × 3 只 + 4 片 595 + SPDT 模式耦合器）→ 嘉立创打样 + SMT。
