guilinbai/iv-measurement/11-Arduino入门与固件编写.md

# Arduino Nano 入门与固件编写（零基础版）

> 目标：让你从"没用过 Arduino"到"能自己改代码、能让引脚输出脉冲、能跑通 4 路测量时序"。
> 配套固件：**《12-固件-4路IV测量.ino》**（可直接打开上传）。

---

## 一、先搞懂一件事：什么叫"控制信号脉冲"

Arduino 的一个数字引脚，**只有两种状态**：

| 状态 | 电压 | 代码 |
|---|---|---|
| 高电平 HIGH | 5 V | `digitalWrite(引脚, HIGH);` |
| 低电平 LOW | 0 V | `digitalWrite(引脚, LOW);` |

**"脉冲"就是：拉高 → 保持一段时间 → 拉低。** 就这么简单：

```cpp
digitalWrite(2, HIGH);   // ① 拉高（5V）
delay(100);              // ② 保持 100 毫秒
digitalWrite(2, LOW);    // ③ 拉低（0V）
delay(100);              // ④ 保持 100 毫秒，然后循环 → 就形成连续脉冲
```

上面 4 行在 D2 上产生的就是**周期 200 ms 的方波**（高 100 ms、低 100 ms），也就是"1 秒 5 个脉冲"。

### 我们的"时序"是什么

我们的时序 = **多个引脚，在不同时刻，各自产生不同长度的脉冲**：

```
D3（短接）  ────┐                    ┌──────────────
                └────────────────────┘
D2（选通）  ─────────┐          ┌──────────────────
                     └──────────┘
             ①断开   ②合上   ③保持   ④断开   ⑤合上
             T_OPEN  T_SETTLE T_DWELL  T_OFF
```

对应代码就是依次写 5 条语句（`measureIsc()` 函数）：

| 步骤 | 代码 | 含义 |
|---|---|---|
| ① 断开短接 | `digitalWrite(PIN_SHORT[ch], LOW);` | 器件脱离短接，开路 |
| 等 30 ms | `delay(T_OPEN);` | 让器件升到 Voc |
| ② 合上选通 | `digitalWrite(PIN_SEL[ch], HIGH);` | 器件接上万用表 |
| 等 80 ms | `delay(T_SETTLE);` | 等瞬态衰减、表稳定 |
| ③ 保持读数 | `delay(T_DWELL);` | 万用表在这 60 ms 内取值 |
| ④ 断开选通 | `digitalWrite(PIN_SEL[ch], LOW);` | 器件离表 |
| 等 20 ms | `delay(T_OFF);` | 确保不同时导通 |
| ⑤ 合上短接 | `digitalWrite(PIN_SHORT[ch], HIGH);` | 回到间隙态 |

**所以"控制信号脉冲"= 引脚电平 + `delay()` 时长。** 你要改时序，就改那几个时间常数（`T_OPEN` / `T_SETTLE` / `T_DWELL` / `T_OFF`），不用改逻辑。

### 为什么不用 PWM（analogWrite）

`analogWrite()` 输出的是**快速开关的 PWM**（约 490 Hz 方波，用来调 LED 亮度/电机转速）。我们需要的是"**慢慢地接通、断开一个开关**"，所以用 `digitalWrite()` ✓

### 精度说明（够用就行）

| 需求 | 用什么 |
|---|---|
| 毫秒级（我们的场景：几十毫秒） | `delay(ms)` ✅ 足够 |
| 微秒级 | `delayMicroseconds(us)` |
| 更精确/非阻塞 | `micros()` 轮询计时，或定时器中断 |

> `delay()` 会"卡住"程序（阻塞）。我们的时序里每个窗口几十毫秒，完全够用；等以后要同时做别的事，再改成 `micros()` 非阻塞写法。

---

## 二、准备工作（一次性的，约 20 分钟）

### 2.1 装 Arduino IDE

1. 打开 `arduino.cc/en/software`
2. 下载 **Arduino IDE**（Windows 版，约 200 MB）
3. 一路下一步装完

### 2.2 插上 Nano、装驱动

1. 用 **USB 数据线**（不是只能充电的线！）把 Nano 插到电脑；
2. 打开**设备管理器**看"端口 (COM 和 LPT)"：
   - 出现 `USB-SERIAL CH340 (COMx)` → ✅ 驱动已就绪，记住这个 **COMx**；
   - 出现带黄色感叹号的"未知设备" → 需要装 CH340 驱动：搜 **`CH341SER`**（沁恒官网）下载安装，或让 Windows 自动更新驱动；
   - 什么都没有 → 换一根数据线（十有八九是线的问题，不是板的问题）。

### 2.3 IDE 里选对板子和端口（**新手最容易卡在这里**）

| 菜单 | 选什么 |
|---|---|
| 工具 → 开发板 | **Arduino AVR Boards → Arduino Nano** |
| 工具 → 处理器 | **ATmega328P**；如果上传报错，改选 **ATmega328P (Old Bootloader)** ← 国产 CH340 板常见 |
| 工具 → 端口 | 选那个 **COMx**（可以拔插一次 Nano，看哪个端口消失又出现） |

---

## 三、第一次上传：让板载 LED 闪起来

**第 1 步**：把下面代码粘进 IDE，点左上角"→"上传：

```cpp
void setup() {
  pinMode(LED_BUILTIN, OUTPUT);      // Nano 板载 LED 在 D13
}
void loop() {
  digitalWrite(LED_BUILTIN, HIGH);   // 亮
  delay(500);
  digitalWrite(LED_BUILTIN, LOW);    // 灭
  delay(500);
}
```

**看到什么算成功**：
- IDE 底部显示 `上传完成`；
- Nano 板上一颗小 LED **每 0.5 秒闪一次** ✅

> 上传失败最常见的原因：处理器没选 `Old Bootloader`、端口选错、USB 线是充电线。

**第 2 步（练习脉冲）**：把 `LED_BUILTIN` 换成 `2`，然后在面包板上接一个 LED 试：

```
Nano D2 ──[1kΩ]── LED 长脚(＋) ── LED 短脚(－) ── Nano GND
```

改一下 `delay()` 的数值（比如 100 / 100），你会看到 LED 闪得快慢变化 —— **这就是"改脉冲宽度"**，也正是我们时序里 `T_SETTLE` 那种参数的意义。

---

## 四、上传我们的 4 路固件

1. 用 Arduino IDE 打开 **《12-固件-4路IV测量.ino》**；
2. 确认板子/处理器/端口选好 → 点上传；
3. 上传成功后，打开 **工具 → 串口监视器**，右下角波特率选 **115200**；
4. 你会看到：

```
==========================================
 4 路 IV 测量控制器  v1.0
 命令: a=自动  i1..i4=测Isc  v1..v4=测Voc
       c=电流模式  u=电压模式  s=安全态
==========================================
当前: 安全态 + 电流模式。输入 a 开始自动循环。
```

### 用串口命令测试（特别适合刚开始调试）

在串口监视器的输入框里敲字符 + 回车：

| 命令 | 作用 | 你会看到 |
|---|---|---|
| `i1` | 手动测一次通道 1 的 Isc | 光耦-3 先灭 → 光耦-1、光耦-2 亮 → 再反过来 |
| `v1` | 手动测一次通道 1 的 Voc | 同上（先确认 `u` 切到电压模式） |
| `a` | 开始/停止自动循环 | 4 路依次动作，停不下来就再按一次 `a` |
| `c` / `u` | 切电流/电压模式 | 光耦-13 亮 或 光耦-14 亮（**绝不同时亮**） |
| `s` | 立刻回安全态 | 4 只短接光耦全亮、选通全灭 |

> **看 LED 就能验证时序对不对**：如果某个时刻"选通"和"短接"用的光耦同时亮着 → 时序错了（这是本项目最关键的检查点）。

---

## 五、和上位机（Python）怎么配合

固件负责"按时序拨开关"，PC 上的 Python 负责"读万用表"，两者用**串口**对齐节奏：

```
PC(Python+pyvisa)                        Nano(固件)
   │  发 "i1"  ─────────────────────────▶│
   │                                      │ ①断短接、②合选通…③保持窗口
   │  读串口直到出现 "WINDOW CH1"  ◀──────│ 在窗口开始时打印一行
   │  此刻万用表已经在读 → 取值            │
   │  取完发 "s"（或继续下一路）─────────▶│ ④断选通、⑤合短接
```

**你现在的阶段**：先用串口命令手动跑通、用 LED 目视确认时序；
**下一阶段**：把 `T_DWELL` 改成"打印 `WINDOW CHn` 后等一下"，PC 端读到这行就读表 —— 这样就不依赖精确的绝对时间。

---

## 六、常见坑（新手基本都会踩一遍）

| # | 现象 | 原因 / 解决 |
|---|---|---|
| 1 | 端口列表里没有 COMx | USB 线是"充电线"（换线）；或没装 CH340 驱动 |
| 2 | 上传报错 `avrdude: stk500_getsync()` | 处理器选项改成 **ATmega328P (Old Bootloader)** |
| 3 | 上传报错 `port busy` | 关掉串口监视器再上传（串口被占用） |
| 4 | 上传成功但没反应 | 端口/板子选错，传到了别的设备；或 LED 接反（长脚是＋） |
| 5 | **`A6`/`A7` 接光耦不动作** | **A6/A7 只能做模拟输入，不能做数字输出**，换 D2~D13 或 A0~A3 |
| 6 | 引脚发烫 / 板子重启 | 单脚电流别超 20 mA（我们的 LED 约 3.75 mA，安全）；所有引脚合计别超 200 mA |
| 7 | LED 一直亮不闪 | 代码没上传成功，或该引脚被别的程序占用 |
| 8 | 光耦不导通 | 光耦 **1、2 脚接反**（1=阳极、2=阴极）；或限流电阻没串对 |
| 9 | 时序看起来对但表读数不对 | 检查地线：控制侧 GND 与测量侧母线 LO **绝不能相连** |

---

## 六.5 实战速查：这台电脑上实测定位过的上传问题

> 实测环境：Arduino IDE 2.x + arduino-cli **1.5.1** + `arduino:avr` **1.8.8** + CH340 驱动 **3.9.2024.9** + Nano 在 **COM9**。

| 报错原文 | 真正原因 | 解决 |
|---|---|---|
| `cannot open port \\.\COM9: 拒绝访问`<br>`unable to open port COM9 for programmer` | **串口监视器独占了端口**（进程名 `serial-monitor`） | **关掉串口监视器再上传**。命令行也可确认/释放：`Get-Process serial-monitor \| Stop-Process -Force` |
| `not in sync: resp=0x00`<br>`programmer is not responding` | **处理器选项选错**（误选了 Old Bootloader）；或 CH340 克隆板**自动复位偶发失效** | 处理器选 **ATmega328P**（**不是** Old Bootloader）；失败就**重试 1~2 次**；仍失败则"点上传后立刻按一下板上 RESET 键" |
| IDE 提示 sketch 名无效 / 无法创建文件夹 | **sketch 名含中文**——Arduino 只允许字母、数字、下划线、连字符 | 用纯英文名（如 `arduino测试\13\13.ino`）；中文名的 .ino 删掉重建 |

**本机验证可用的上传配置**（照这个选，一次成功）：

| 项 | 值 |
|---|---|
| 开发板 | **Arduino Nano** |
| 处理器 | **ATmega328P** ← 不是 Old Bootloader |
| 端口 | **COM9**（USB-SERIAL CH340） |
| 操作顺序 | ① 关串口监视器 → ② 点上传 → ③ 传完再开监视器 |

> 💡 **两条铁律**（本项目尤其重要，因为你要一边看串口一边量万用表）：
> 1. **串口监视器开着 = 无法上传**（报"拒绝访问"）；
> 2. **每次改完代码上传前，先关监视器**。

---

## 七、测电压最容易误会的一件事：光耦 1 脚只有 1.1 V

接好光耦后，很多人会拿万用表去量"D2 有没有输出 5 V"，结果在**光耦 1 脚**上量到 **1.0~1.3 V**，以为板子坏了。**其实完全正常。**

### 各点的正常读数

| 表笔位置 | 正常读数 | 含义 |
|---|---|---|
| **Nano 的 D2 引脚本身**（或电阻靠 D2 的那一端） | **≈ 5.0 V** | 这才是引脚的输出电压 |
| 电阻另一端 = **光耦 1 脚（LED 阳极）** | **1.0 ~ 1.3 V** | LED 的正向压降 Vf |
| 光耦 2 脚 / GND 蓝轨 | 0 V | 参考地 |

### 为什么？限流电阻就是"吃掉多余的电压"

```
  5.0 V ──[ 1 kΩ ]── 1.1 V ──[ 红外 LED ]── 0 V
   (D2)      ↑           ↑
         吃掉 3.9 V   LED 只需要 1.1 V

  电流 = 3.9 V ÷ 1 kΩ ≈ 3.9 mA   ← 正是设计值（3.75 mA 附近）✓
```

**反过来说：如果你在光耦 1 脚量到 5 V，那才说明有问题**——LED 回路没通、没有电流、光耦不会导通（常见原因：1/2 脚接反、LED 虚接、电阻没插到位）。

### 真正该做的验证（3 步）

| 步骤 | 怎么做 | 正常结果 |
|---|---|---|
| ① 验引脚 | 表笔戳 **D2 引脚本身**，黑笔接蓝轨 | ≈ 5.0 V |
| ② 验 LED | 表笔跨在 **光耦 1 脚与 2 脚**之间 | 1.0~1.3 V |
| ③ **验光耦有没有真的导通**（最关键） | 万用表切**电阻档/通断档**，测**光耦的 3、4 脚**：串口敲 `i1` 再敲 `s` | `i1` 时导通（几 Ω~几十 Ω，蜂鸣响）；`s` 时开路（OL） |

> 第 ③ 步才是真正证明"LED 亮 → 输出侧导通"这条链路通了。**只看 LED 亮不亮不够**（LED 亮但输出侧没接对，照样测不到东西）。

### 如果 D2 引脚本身（空载）也只有 1.1 V，那才需要排查

| # | 检查项 | 怎么查 |
|---|---|---|
| 1 | 固件传进去了吗 | 串口监视器（115200）能否看到启动横幅；敲 `a` 有没有反应 |
| 2 | 引脚认错了吗 | 面包板上 Nano 的引脚极易差一格。用**通断档**确认"D2 那个孔"和"Nano 的 D2 脚"是同一网络 |
| 3 | 5 V 本身正常吗 | 量 Nano 的 5V 引脚对 GND：应 4.9~5.1 V；不足则是 USB 线/口的问题 |
| 4 | 引脚被烧过吗 | 之前若直接短路或灌过大电流可能损坏。换 D12 试（固件里把 `PIN_SEL[0]` 改成 12），若 D12 正常说明 D2 坏了，弃用它 |
| 5 | 引脚是浮空态吗 | 只有 `pinMode(pin, OUTPUT)` 之后 `digitalWrite` 才真正驱动；固件里已设置，但如果你在跑自己的测试代码，先检查这一句 |
| 6 | **HIGH 时只有 1~2 V（LOW 正常）** | 这是"引脚高边驱动损坏"或"测点上仍挂负载"的典型症状。诊断三步：① 直接戳 **Nano 排针本身**（绕开面包板）——若是 5 V，问题在面包板/接线；② 检查代码有没有误用 `analogWrite()`（PWM 平均值会造成低压假象）；③ **改固件换一个空闲引脚**（如把 `PIN_SEL[0]` 从 2 改成 12）对比——新引脚正常即可断定原引脚已损坏 |
| 7 | 引脚怎么会被烧坏 | ① 引脚**直接短接 5V/GND**（没串电阻）；② LED **没串限流电阻**；③ 带电插拔；④ 静电。预防：**接线前先拔 USB**、LED 必串 1 kΩ、绝不把引脚直接连到电源轨 |
| 8 | **忘记 `pinMode(pin, OUTPUT)`（最高频的坑）** | 引脚默认是**输入（高阻）**。此时 `digitalWrite(pin, HIGH)` 不是"输出 5 V"，而是**接通约 20~50 kΩ 的内部上拉**，只能给约 0.1 mA，带不动任何负载。**真实案例**：只写了 `pinMode(LED_BUILTIN, OUTPUT)` 却对 D2 做 `digitalWrite`，结果在光耦 1 脚量到 **1.08 V**（= 红外 LED 在上拉微弱电流下的正向压降）、LOW 时量到 0.07 V。**这个读数恰恰证明"回路是通的、LED 正向导通、只是电流太小"，引脚并没有坏**——加上 `pinMode(2, OUTPUT);` 后 HIGH 立刻变成 5 V |

---

## 八、想改什么，改哪里

| 你想做的事 | 改哪里 |
|---|---|
| 调整等待时间（器件/表不同） | `T_OPEN` / `T_SETTLE` / `T_DWELL` / `T_OFF` 四个常量 |
| 调整整轮间隔（采样周期） | `T_INTERVAL`
| 只做 2 路 | 把循环上限 `4` 改成 `2`，并把 `PIN_*` 数组只留前两个 |
| 扩到 8 路 | `PIN_SEL` / `PIN_SHORT` 各加 4 个引脚（8 路需要 16 个引脚 → 得用 74HC595，见文件九 §3） |
| 默认用电压模式 | `setup()` 里把 `switchMode(true)` 改成 `switchMode(false)` |
| 加温度传感器 | 用 A4/A5（I2C），读 SHT31/DS18B20 后一起从串口输出 |

---

## 八、一句话总结

> **脉冲 = `digitalWrite(HIGH)` + `delay(一段时间)` + `digitalWrite(LOW)`。**
> 我们的"测量时序"就是把这 5 步按顺序写出来；你只要改那几个 `T_*` 时间常数就能调快调慢。
> 上传流程：装 IDE → 装 CH340 驱动 → 选 Nano + ATmega328P(Old Bootloader) + COMx → 点上传 → 串口监视器 115200 看日志。
