guilinbai/iv-measurement/5-面包板排线教程.md

# 面包板排线教程（4 路原型 · 零焊接）

> 对应仿真文件《3-仿真图-Arduino自动版.txt》里的元件编号。**照着本表逐根接线即可，不需要看懂电路。**
> 需要：Arduino Nano ×1、AQY212EH 光耦 ×**14**、1 kΩ 电阻 ×**14**、830 孔面包板 ×**3**、杜邦线若干、KF301-2P 端子 ×4。
>
> 📐 **配套图纸**（先看图再看表，效率最高）：
> - 《**6-单通道接线详图.svg**》→ 一个通道怎么接，特别是 **1kΩ 限流电阻**接在哪（这是仿真图里看不到的部分）
> - 《**7-系统整体结构图.svg**》→ 4 路的整体结构、14 只光耦的分工、母线与万用表三端口的连接

---

## 0. 一分钟看懂整体结构

```
   板1（控制侧）        板2（光耦区）              板3（测量侧）
  ┌──────────────┐   ┌────────────────────┐   ┌──────────────────────┐
  │ Arduino Nano │   │ 14 只光耦 + 14 只  │   │ 红轨 = 母线 HI       │
  │  5V/GND 电源轨│──▶│ 1kΩ 电阻           │──▶│ 蓝轨 = 母线 LO       │
  │              │   │                    │   │ 4 个器件端子 ch1~ch4 │
  └──────────────┘   └────────────────────┘   └──────────────────────┘
       D2~D11 ─────────┘  （10 根控制线 + 1 根 GND）
                          每只光耦的 3/4 脚 ──▶ 板3 的器件端子与母线
```

**为什么分成 3 块板**：控制侧（板1+板2 的 LED 回路）与测量侧（板2 的输出侧 + 板3）**不共地**，光耦是唯一的跨接桥梁——这正是真实系统的隔离方式。板 2 的蓝轨只做**控制侧 GND**，绝不能接到板 3 的蓝轨（母线 LO）。

---

## 1. 光耦编号规则

**编号 = 通道顺序 × 3 + 用途**，与仿真图上的标注一一对应：

| 光耦编号 | 用途 | 位置（面包板上） | 仿真图标注 |
|---|---|---|---|
| **光耦-1** | 通道1 选通 A（器件A端 ↔ 母线HI） | 板2 | 光耦1（选通A1） |
| **光耦-2** | 通道1 选通 B（器件B端 ↔ 母线LO） | 板2 | 光耦2（选通B1） |
| **光耦-3** | 通道1 短接（器件A端 ↔ 器件B端） | 板2 | 光耦3（短接1） |
| **光耦-4** | 通道2 选通 A | 板2 | 光耦4（选通A2） |
| **光耦-5** | 通道2 选通 B | 板2 | 光耦5（选通B2） |
| **光耦-6** | 通道2 短接 | 板2 | 光耦6（短接2） |
| **光耦-7** | 通道3 选通 A | 板2 | 光耦7（选通A3） |
| **光耦-8** | 通道3 选通 B | 板2 | 光耦8（选通B3） |
| **光耦-9** | 通道3 短接 | 板2 | 光耦9（短接3） |
| **光耦-10** | 通道4 选通 A | 板2 | 光耦10（选通A4） |
| **光耦-11** | 通道4 选通 B | 板2 | 光耦11（选通B4） |
| **光耦-12** | 通道4 短接 | 板2 | 光耦12（短接4） |
| **光耦-13** | **模式耦合器·电流**（母线HI ↔ DMM电流端口） | 板2 | 光耦13（模式·电流） |
| **光耦-14** | **模式耦合器·电压**（母线HI ↔ DMM电压端口） | 板2 | 光耦14（模式·电压） |

**总数 = 4 路 × 3 只 + 2 只模式耦合器 = 14 只** ✓

---

## 2. 每只光耦的 4 个引脚定义（AQY212EH / AQY272 都是 DIP-4，定义相同）

| 引脚 | 名称 | 属于哪一侧 | 接到什么 |
|---|---|---|---|
| **1 脚** | LED 阳极 | **控制侧** | 经一只 1 kΩ 电阻 → Arduino 数字引脚 |
| **2 脚** | LED 阴极 | **控制侧** | 控制侧 GND（板2 蓝轨） |
| **3 脚** | 输出端 | **测量侧** | 见第 3 节表格 |
| **4 脚** | 输出端 | **测量侧** | 见第 3 节表格 |

> **3、4 脚无极性**，可以互换（表里按"3 接器件侧、4 接母线侧"的惯例写，便于检查）。
> **1、2 脚不能接反**：1 脚是阳极（长脚/靠缺口标记），反接不亮。

---

## 3. 完整接线总表（14 只 × 4 脚 = 56 行）

**限流电阻命名**：R1~R14 分别串在光耦-1 ~ 光耦-14 的 1 脚上（每只光耦一个，**不要两只共用一个电阻**）。

### 通道 1（光耦-1 / 2 / 3）

| 光耦·引脚 | 用途 | 接到哪里 |
|---|---|---|
| 光耦-1-1 | ch1 选通A · LED阳极 | 经 **R1(1kΩ)** → Arduino **D2** |
| 光耦-1-2 | LED阴极 | 控制侧 GND（板2 蓝轨） |
| **光耦-1-3** | 输出 | **ch1 器件 A 端子** |
| **光耦-1-4** | 输出 | **母线 HI**（板3 红轨） |
| 光耦-2-1 | ch1 选通B · LED阳极 | 经 **R2(1kΩ)** → Arduino **D2**（与光耦-1 同一引脚） |
| 光耦-2-2 | LED阴极 | 控制侧 GND（板2 蓝轨） |
| **光耦-2-3** | 输出 | **ch1 器件 B 端子** |
| **光耦-2-4** | 输出 | **母线 LO**（板3 蓝轨） |
| 光耦-3-1 | ch1 短接 · LED阳极 | 经 **R3(1kΩ)** → Arduino **D3** |
| 光耦-3-2 | LED阴极 | 控制侧 GND（板2 蓝轨） |
| **光耦-3-3** | 输出 | **ch1 器件 A 端子**（与光耦-1-3 同一点） |
| **光耦-3-4** | 输出 | **ch1 器件 B 端子**（与光耦-2-3 同一点） |

### 通道 2（光耦-4 / 5 / 6）

| 光耦·引脚 | 用途 | 接到哪里 |
|---|---|---|
| 光耦-4-1 | ch2 选通A · LED阳极 | 经 **R4(1kΩ)** → Arduino **D4** |
| 光耦-4-2 | LED阴极 | 控制侧 GND（板2 蓝轨） |
| **光耦-4-3** | 输出 | **ch2 器件 A 端子** |
| **光耦-4-4** | 输出 | **母线 HI**（板3 红轨） |
| 光耦-5-1 | ch2 选通B · LED阳极 | 经 **R5(1kΩ)** → Arduino **D4**（与光耦-4 同一引脚） |
| 光耦-5-2 | LED阴极 | 控制侧 GND（板2 蓝轨） |
| **光耦-5-3** | 输出 | **ch2 器件 B 端子** |
| **光耦-5-4** | 输出 | **母线 LO**（板3 蓝轨） |
| 光耦-6-1 | ch2 短接 · LED阳极 | 经 **R6(1kΩ)** → Arduino **D5** |
| 光耦-6-2 | LED阴极 | 控制侧 GND（板2 蓝轨） |
| **光耦-6-3** | 输出 | **ch2 器件 A 端子**（与光耦-4-3 同一点） |
| **光耦-6-4** | 输出 | **ch2 器件 B 端子**（与光耦-5-3 同一点） |

### 通道 3（光耦-7 / 8 / 9）

| 光耦·引脚 | 用途 | 接到哪里 |
|---|---|---|
| 光耦-7-1 | ch3 选通A · LED阳极 | 经 **R7(1kΩ)** → Arduino **D6** |
| 光耦-7-2 | LED阴极 | 控制侧 GND（板2 蓝轨） |
| **光耦-7-3** | 输出 | **ch3 器件 A 端子** |
| **光耦-7-4** | 输出 | **母线 HI**（板3 红轨） |
| 光耦-8-1 | ch3 选通B · LED阳极 | 经 **R8(1kΩ)** → Arduino **D6**（与光耦-7 同一引脚） |
| 光耦-8-2 | LED阴极 | 控制侧 GND（板2 蓝轨） |
| **光耦-8-3** | 输出 | **ch3 器件 B 端子** |
| **光耦-8-4** | 输出 | **母线 LO**（板3 蓝轨） |
| 光耦-9-1 | ch3 短接 · LED阳极 | 经 **R9(1kΩ)** → Arduino **D7** |
| 光耦-9-2 | LED阴极 | 控制侧 GND（板2 蓝轨） |
| **光耦-9-3** | 输出 | **ch3 器件 A 端子**（与光耦-7-3 同一点） |
| **光耦-9-4** | 输出 | **ch3 器件 B 端子**（与光耦-8-3 同一点） |

### 通道 4（光耦-10 / 11 / 12）

| 光耦·引脚 | 用途 | 接到哪里 |
|---|---|---|
| 光耦-10-1 | ch4 选通A · LED阳极 | 经 **R10(1kΩ)** → Arduino **D8** |
| 光耦-10-2 | LED阴极 | 控制侧 GND（板2 蓝轨） |
| **光耦-10-3** | 输出 | **ch4 器件 A 端子** |
| **光耦-10-4** | 输出 | **母线 HI**（板3 红轨） |
| 光耦-11-1 | ch4 选通B · LED阳极 | 经 **R11(1kΩ)** → Arduino **D8**（与光耦-10 同一引脚） |
| 光耦-11-2 | LED阴极 | 控制侧 GND（板2 蓝轨） |
| **光耦-11-3** | 输出 | **ch4 器件 B 端子** |
| **光耦-11-4** | 输出 | **母线 LO**（板3 蓝轨） |
| 光耦-12-1 | ch4 短接 · LED阳极 | 经 **R12(1kΩ)** → Arduino **D9** |
| 光耦-12-2 | LED阴极 | 控制侧 GND（板2 蓝轨） |
| **光耦-12-3** | 输出 | **ch4 器件 A 端子**（与光耦-10-3 同一点） |
| **光耦-12-4** | 输出 | **ch4 器件 B 端子**（与光耦-11-3 同一点） |

### 模式耦合器（光耦-13 / 14）

| 光耦·引脚 | 用途 | 接到哪里 |
|---|---|---|
| 光耦-13-1 | 电流模式 · LED阳极 | 经 **R13(1kΩ)** → Arduino **D10** |
| 光耦-13-2 | LED阴极 | 控制侧 GND（板2 蓝轨） |
| **光耦-13-3** | 输出 | **母线 HI**（板3 红轨） |
| **光耦-13-4** | 输出 | **DMM 电流端口**（红表笔 / 香蕉插座） |
| 光耦-14-1 | 电压模式 · LED阳极 | 经 **R14(1kΩ)** → Arduino **D11** |
| 光耦-14-2 | LED阴极 | 控制侧 GND（板2 蓝轨） |
| **光耦-14-3** | 输出 | **母线 HI**（与光耦-13-3 同一点） |
| **光耦-14-4** | 输出 | **DMM 电压端口** |

> ⚠️ **互锁铁律**：固件里 **D10 与 D11 绝不可同时为 HIGH**（1 Ω 电流档会把 10 MΩ 电压档旁路，电压读数立刻失效）。默认状态：**D10 = HIGH（电流模式）**、**D11 = LOW**。

---

## 4. Arduino Nano 引脚表（每个引脚的用途）

| 引脚 | 本项目的用途 | 接到哪里 |
|---|---|---|
| **D0 (RX)** | 串口接收 | USB 转串口，**不接外部** |
| **D1 (TX)** | 串口发送 | USB 转串口，**不接外部** |
| **D2** | ch1 选通（驱动 2 只 LED） | 经 R1→光耦-1-1，经 R2→光耦-2-1 |
| **D3** | ch1 短接 | 经 R3→光耦-3-1 |
| **D4** | ch2 选通 | 经 R4→光耦-4-1，经 R5→光耦-5-1 |
| **D5** | ch2 短接 | 经 R6→光耦-6-1 |
| **D6** | ch3 选通 | 经 R7→光耦-7-1，经 R8→光耦-8-1 |
| **D7** | ch3 短接 | 经 R9→光耦-9-1 |
| **D8** | ch4 选通 | 经 R10→光耦-10-1，经 R11→光耦-11-1 |
| **D9** | ch4 短接 | 经 R12→光耦-12-1 |
| **D10** | 模式耦合器·**电流**（默认 HIGH） | 经 R13→光耦-13-1 |
| **D11** | 模式耦合器·**电压**（默认 LOW） | 经 R14→光耦-14-1 |
| D12 | 空闲备用 | — |
| D13 | 空闲备用（板载 LED） | — |
| A0 ~ A3 | 空闲备用（可作数字 I/O） | — |
| **A4 (SDA)** | 温度传感器预留 | 本期不接 |
| **A5 (SCL)** | 温度传感器预留 | 本期不接 |
| **A6 / A7** | ⚠️ **只能作模拟输入** | 不能用于驱动光耦 |
| **5V** | 逻辑电源 | 板1 红轨（+5 V）——**4 路原型里红轨是空的／备用**，见下方说明 |
| **GND** | 逻辑地 | 板1/板2 蓝轨（**控制侧 GND**）——**这根必不可少** |
| **VIN** | 外部 7~12 V 输入 | 不用（走 USB 或 5V 脚供电） |
| **3V3** | 3.3 V 输出 | 不用 |
| **AREF / RESET** | 参考电压 / 复位 | 不用 |

**引脚占用小结**：4 路共 **10 个数字输出**（D2~D11），剩下 D12/D13/A0~A3 备用，A4/A5 留给温度 ✓

> **⚠️ 5V 红轨在 4 路原型里是空的，这是正常的**：光耦的 LED 由 **Arduino 引脚直接驱动**（引脚 HIGH=5V → 经 1kΩ → 光耦 1 脚 → 光耦 2 脚 → GND），**电流不经过 5V 轨**。
> - **必须接的只有蓝轨（GND）**：Nano GND → 板1 蓝轨 → 一根跳线跨到板2 蓝轨 → 板2 上 14 只光耦的 2 脚。缺这根线光耦一只都不亮。
> - **红轨留着备用**：接一个电源指示灯（LED + 1kΩ 跨在红蓝轨之间）能一眼看出通没通电；以后 74HC595 的 VCC、温度传感器也从它取电。
> - **绝不要改成"红轨 + 引脚拉低"（灌电流）接法**：那会让逻辑反过来（引脚 LOW 才导通），与固件和安全态完全相反。

**电流核对**：每只 LED 约 3.75 mA（1 kΩ 从 5 V：(5−1.25)/1000）；一个选通脚驱动 2 只 = 7.5 mA ✓（ATmega 单脚推荐 ≤20 mA）；间隙态 4 路短接位同时导通 = 4 × 3.75 ≈ 15 mA ✓ 5 V/1 A 电源裕量充足。

---

## 5. 测量侧接线表（板3）

| 测量侧节点 | 从哪来 | 去哪 |
|---|---|---|
| **母线 HI**（板3 红轨） | 光耦-1-4、光耦-4-4、光耦-7-4、光耦-10-4、光耦-13-3、光耦-14-3 | → 光耦-13/14 的输出侧，经模式耦合器到 DMM |
| **母线 LO**（板3 蓝轨） | 光耦-2-4、光耦-5-4、光耦-8-4、光耦-11-4 | → **DMM 公共端（黑）** |
| ch1 器件端子（KF301-2P） | A 脚 ← 光耦-1-3 + 光耦-3-3；B 脚 ← 光耦-2-3 + 光耦-3-4 | → 被测器件1 |
| ch2 器件端子 | A ← 光耦-4-3 + 光耦-6-3；B ← 光耦-5-3 + 光耦-6-4 | → 被测器件2 |
| ch3 器件端子 | A ← 光耦-7-3 + 光耦-9-3；B ← 光耦-8-3 + 光耦-9-4 | → 被测器件3 |
| ch4 器件端子 | A ← 光耦-10-3 + 光耦-12-3；B ← 光耦-11-3 + 光耦-12-4 | → 被测器件4 |
| **DMM 电流端口** | ← 光耦-13-4 | 接 DMM6500 电流输入（红） |
| **DMM 电压端口** | ← 光耦-14-4 | 接 DMM6500 电压输入（红） |
| **DMM 公共端（黑）** | ← 母线 LO | 接 DMM6500 INPUT LO |

**器件引线**：每个器件两根线（A 红 / B 黑），用 **24 AWG 双绞线**（或网线成对取用），长度 ≤1 m，两端挂线标 `ch1-A / ch1-B`…

**关于 KF301-2P 端子（为什么每通道要一个）**：它是一个**绿色小塑料块 + 两颗螺丝**的接线柱，背面两根金属针（间距 5.08mm，正好跨面包板 2 个孔，可直接插）。

- **怎么接**：器件 A 端线剥皮插左边孔、B 端线插右边孔 → **拧紧螺丝压住**，不需要焊接；
- **为什么要它**：① 你不会焊接，这是唯一不焊的器件接法；② 器件要换（扩路/换样品）时拧松即可；③ 螺钉压紧比面包板簧片可靠，适合 7 天连续运行；④ A/B 分左右两孔，防插错；
- **在哪**：面包板方案里 4 个插在板 3；PCB 方案里就是 J2~J5。

---

## 6. 建议的搭建顺序（按这个顺序不容易返工）

| 步骤 | 做什么 | 检查点 |
|---|---|---|
| ① | 板1 插上 Nano，红轨接 5V、蓝轨接 GND，插上 USB 供电 | 板载电源灯亮 |
| ② | 板2 按"光耦-1 到光耦-14"从左到右插好，**统一缺口朝向左边** | 14 只位置对齐，1 脚都在左 |
| ③ | 板2 插 14 只 1 kΩ 电阻（每只光耦的 1 脚各一只） | 电阻不共用 |
| ④ | 接 10 根控制线（板1 D2~D11 → 板2 各电阻 → 光耦 1 脚） | 用不同颜色杜邦线，按 D2~D11 顺序 |
| ⑤ | 把 14 只光耦的 **2 脚**统一接到板2 蓝轨（控制侧 GND） | 用一根跳线做"2 脚公共轨"更整洁 |
| ⑥ | 板3 红轨当母线 HI、蓝轨当母线 LO；把 4 只选通A光耦的 4 脚 → 红轨，4 只选通B光耦的 4 脚 → 蓝轨 | 逐一核对，别接反（A→HI、B→LO） |
| ⑦ | 4 个器件端子插到板3，按第 5 节把器件 A/B 线接好 | 每通道 4 根线（1-3、2-3、3-3、3-4） |
| ⑧ | 模式耦合器：光耦-13/14 的 3 脚 → 母线 HI，4 脚 → DMM 电流/电压端口 | 见第 3 节表 |
| ⑨ | 母线 LO → DMM 公共端；DMM 电流/电压端口线接好 | 三条 DMM 线就位 |

**排线美观小技巧**：控制线（板1→板2）全部走面包板上方、测量线（板2→板3）全部走下方，两类线不要捆在一起——既好查线，也减少串扰。

---

## 7. 上电前检查清单（务必逐条过）

| # | 检查项 | 正确状态 |
|---|---|---|
| 1 | 光耦 1、2 脚有没有接反 | 1 脚经电阻到 D 引脚，2 脚到控制侧 GND |
| 2 | 每个光耦的 1 脚是不是**各自**有一只 1 kΩ | 不允许两只共用一个电阻 |
| 3 | 控制侧 GND 与测量侧母线 LO 是否**意外短接** | **必须开路**（用万用表量：应为无穷大） |
| 4 | 光耦 3、4 脚有没有接到控制侧 | 3/4 脚只在测量侧 |
| 5 | 母线 HI 与母线 LO 之间量电阻 | 电流模式下经 1 Ω 取样电阻读到约 1 Ω（真实 DMM 内阻更小，接近短路） |
| 6 | D10 与 D11 是否同时为 HIGH | 固件上电必须 `D10=HIGH, D11=LOW`，且做互锁 |
| 7 | 器件端子有没有接错通道 | ch1~ch4 线标一致 |

---

## 8. 上电自检（不用万用表也能验）

1. **上电瞬间**：固件应把所有短接位拉高 → 14 只光耦里 4 只短接光耦 + 1 只模式耦合器亮（约 5 只 LED）；
2. **让固件执行"测一次 ch1"**：会看到 **光耦-3（短接1）先灭** → 然后 **光耦-1、光耦-2 同时亮** → 再反过来（先灭 1、2，再亮 3）。**如果看到"1、2 和 3 同时亮"，说明时序反了**，对照《1-测试系统目的与设计.md》§2.3 检查固件；
3. **依次测 ch2/ch3/ch4**：同样只应有对应的 2 只选通光耦亮起；
4. **切到电压模式**：光耦-13 灭、光耦-14 亮（两者绝不同时亮）；
5. 确认无误后再接被测器件和万用表。

---

*本教程与《1-测试系统目的与设计.md》配套；仿真对照见《3-仿真图-Arduino自动版.txt》。*
