guilinbai/iv-measurement/8-面包板接线图画法.md

# 面包板接线图画法（工具与步骤）

> 需求：**只要能把"实物怎么插线"画清楚，不需要仿真电流。**
> 结论：用 **Fritzing**（免费离线，面包板视图是它的招牌）。不想装软件就用 **breadboard 照片 + 画线**，零学习成本。

---

## 1. 先把工具分成两类（你要的是左边这类）

| | 画图连线类（← 你要的） | 仿真类（不需要） |
|---|---|---|
| 工具 | **Fritzing**、Tinkercad Circuits、draw.io + 面包板照片、CRUMB | CircuitJS、Proteus、Wokwi、EveryCircuit |
| 画出来 | **面包板 + 元件本体 + 彩色跳线**（实物风格） | 原理图符号 + 波形 |
| 会不会仿真 | 不会（也不影响用） | 会 |

> ⚠️ **CircuitJS / Proteus / KiCad 都画不出"实物样子"**——它们只画符号。所以之前我那几张 SVG 你看着抽象，是因为它们本质是"符号级"的图。**要实物感，必须用 Fritzing 这一类。**

---

## 2. 首选：Fritzing

### 2.1 它为什么正好合适

- 一个电路有 **面包板视图 / 原理图视图 / PCB 视图** 三种，**你在面包板视图里拖，图就是实物样子**；
- 面包板是**真的分区**（红蓝电源轨、中间隔离槽、63 列孔）；
- 跳线是**可以弯曲、可以改颜色**的曲线，跟杜邦线一样；
- **DIP 元件可以自定义引脚数** → 建一个 4 脚 IC 就是"光耦"；
- 画完可导出 PNG，**打印 A3 贴在工作台上照着插**。

### 2.2 下载与版本

| 渠道 | 说明 |
|---|---|
| 官网 fritzing.org/download | 现在是"自愿付费"（最低约 €8），付了会收到下载链接 |
| GitHub 源码自行编译 | 免费（需要一点动手能力） |
| 网上流传的 0.9.3b 旧版 | 免费，功能对本项目完全够用（面包板视图早就有） |

### 2.3 从零画这张图（约 30~40 分钟）

**第 1 步：建 14 只"光耦"元件**
1. 在 **面包板视图** 里，从右侧元件库 `MISC` → 拖入 **Generic IC**；
2. 双击它 → 引脚数填 **4**、封装选 **DIP**、名字填 `Opto-1`；
3. 重复或复制粘贴，做出 `Opto-1` ~ `Opto-14`（分别对应排线教程里的编号）。

**第 2 步：摆元件（照下表）**

| 板 | 放什么 | 摆放要点 |
|---|---|---|
| 板 1 | Arduino Nano ×1 | 跨中间槽，占 15 列；红轨接 5V、蓝轨接 GND |
| 板 2 | `Opto-1`~`Opto-14` ×14 | **横排**，每只跨中间槽占 2 列，间隔 1 列（共用约 42 列，一块 830 孔板能放下） |
| 板 2 | 1 kΩ 电阻 ×14 | 每只光耦旁边**竖插**一只（4 孔高） |
| 板 3 | 2P 螺钉端子 ×4 | 一排 4 个，做器件 A/B 端子 |
| 板 3 | 香蕉插座 ×2 | 接万用表的电流/电压端口 |

**第 3 步：连线（颜色按这个习惯，方便查线）**

| 线 | 颜色 | 从 | 到 |
|---|---|---|---|
| 控制线 ×10 | 蓝 | Nano 的 D2~D11 | 各电阻一端（每路一只电阻） |
| 电阻另一端 | 蓝 | 电阻另一端 | 光耦 **1 脚** |
| 光耦 2 脚 | 绿 | 全部 14 只的 2 脚 | 板 2 蓝轨（**控制侧 GND**） |
| 电源 | 红/黑 | 板 1 红轨/蓝轨 | Nano 5V / GND |
| **母线 HI** | **红** | 4 只"选通A光耦"的 4 脚 + 光耦13/14 的 3 脚 | 板 3 的母线 HI |
| **母线 LO** | **黑** | 4 只"选通B光耦"的 4 脚 | 板 3 的母线 LO → 万用表公共端 |
| 器件 A/B 线 ×8 | 黄/橙 | 光耦 3/4 脚 | 4 个 2P 端子 |
| 光耦13/14 输出 | 紫 | 光耦13-4 / 光耦14-4 | 香蕉插座（万用表电流/电压端口） |

> 每根线连到哪，**完整表格见《5-面包板排线教程.md》第 3 节**（14 只 × 4 脚 = 56 行），照着抄就行。

**第 4 步：导出**
`File → Export → as Image → PNG`，选高分辨率；打印时选 A3、横向。

### 2.4 偷懒技巧

先把 **1 只光耦 + 1 只电阻 + 3 根跳线**摆好连好，然后**框选整组复制 14 次**，再逐组只改"跳线的目标引脚"——比从零画快得多。

---

## 3. 不想装软件？三个零/低成本替代

### 3.1 面包板照片 + 画线（最"实物"，零学习成本）⭐

1. 买回面包板后**拍一张俯视照片**（或从网上找一张同型号的空板照片）；
2. 用 **Windows 画图 / PPT / Snipaste / draw.io** 打开照片；
3. 直接在照片上：**贴元件图片**（光耦、电阻、Nano 的实物照片）+ **画彩色曲线**当跳线；
4. 存成 PNG 打印。

**优点**：100% 是实物，不需要任何元件库。
**缺点**：手工活儿，改线要重画。

### 3.2 Tinkercad Circuits（在线免费）

- 网址 `tinkercad.com/circuits`，注册即用，**不用装任何东西**；
- 元件是 3D 实物外观，面包板分区真实，连线简单；
- **只要画图不点运行就行**（它带仿真，但你不点就没关系）；
- 缺点：元件库没有"光耦"，可以用"继电器"或"光耦(如果有)"替代；画的图不便导出高分辨率。

### 3.3 draw.io / diagrams.net（在线免费）

- 有电子元件符号库，但偏**原理图符号**，不是实物外观；
- 适合"在面包板照片上叠加连线"（配合 3.1 用）。

---

## 4. 画完这张图你能得到什么

| 用途 | 好处 |
|---|---|
| 打印出来放工作台 | 插线时**不用再翻文档**，逐根对 |
| 查线/排错 | 哪根线该在哪，一眼可见（比读表格快得多） |
| 改版 | 以后扩到 8 路/16 路，在图上加一组即可 |
| 交接 | 别人拿着图就能复现你的接线 |

---

## 5. 一句话总结

> **要实物感、要能连线、不要仿真 → 装 Fritzing（面包板视图）。**
> 不想装软件 → **拍张面包板照片，在照片上用画图软件贴元件、画跳线。**
> 仿真类的工具（CircuitJS / Wokwi / Proteus）解决的是"电路对不对"，不是"手怎么插"，本项目已经用 CircuitJS 验证过时序，剩下要的就是一张**给手看的图**。

---

## 6. 如果你也不想自己画

告诉我"**帮我出实物接线图**"，我可以按《5-面包板排线教程.md》的 56 行表，直接画一张**面包板实物风格**的图（画成有孔的板子 + 元件本体 + 彩色跳线，而不是电气符号），你核对后就能打印。
