guilinbai/iv-measurement/9-PCB打板与四路板设计.md

# PCB 打板与四路测量板设计

---

## 一、什么是"PCB 打板"

**PCB** = Printed Circuit Board，印制电路板。**"打板"**就是把你在电脑上画好的电路板文件交给工厂，让他们把板子**生产出来**。

### 完整流程（5 步）

```
① 画原理图      在 EDA 软件里把"哪个引脚连哪个引脚"画出来（= 我们的网表）
② 转 PCB 布局   元件摆到板子上的实际位置（位置、间距、接口朝向）
③ 布线          用铜线把该连的连起来（走线宽度、间距、过孔、覆铜）
④ 导出 Gerber   一套描述"每层长什么样"的标准文件（工厂只认这个）
⑤ 下单生产      选板厚/颜色/工艺 → 工厂开料、钻孔、曝光、蚀刻、丝印、喷锡、成型
```

### 和面包板的区别

| | 面包板 | PCB 打板 |
|---|---|---|
| 连接方式 | 插孔簧片 | **焊接**（或 SMT 代贴） |
| 可靠性 | 接触电阻会变、会松动 | 焊死，**适合 7 天连续运行** |
| 体积 | 大 | 小（4 路可做到 100×80 mm 以内） |
| 成本 | 面包板 ~10 元，可反复用 | 打样 5 片约 **5~30 元**（首单特价）+ 运费；SMT 代贴工程费约 50~100 元 |
| 周期 | 立刻 | 打样 **3~5 天** |
| 适用阶段 | 验证逻辑、试错 | 定稿量产的形态 |

> 你的项目正好是"面包板验证 → PCB 定稿"两阶段：`5-面包板排线教程.md` 是第一阶段，本文件是第二阶段。

---

## 二、用什么软件做

| 软件 | 价格 | 上手难度 | 适合你吗 |
|---|---|---|---|
| **立创EDA**（嘉立创） | **免费** | ★★★★★ 中文界面 | ✅✅ **首选**：元件库直接连着嘉立创商城（有库存、有编号、有价格），画完**一键下单打板 + SMT 代贴**，不需要导出 Gerber 再找工厂 |
| **KiCad** | 免费开源 | ★★★☆☆ | ✅ 次选：功能专业、国际通用；但元件库要自己管理，打板要自己导出 Gerber 再上传 |
| **Altium Designer** | 数万元 | ★★☆☆☆ | ❌ 企业级，本项目没必要 |
| **EasyEDA 国际版** | 免费 | ★★★★☆ | 立创EDA 的海外版，功能相同 |

**结论：用立创EDA（标准版就够，专业版也行）。** 理由：不用装软件（网页版也有桌面版）、中文、元件库直连商城、一键下单、SMT 代贴都在同一个网站完成。

---

## 三、四路测量板设计规格

### 3.1 总体参数

| 项 | 规格 |
|---|---|
| 板框尺寸 | **100 × 80 mm**（在嘉立创 10×10cm 打样档内，最便宜） |
| 层数 | **2 层**（控制与测量都在顶层走线，底层做控制侧地平面） |
| 板厚 | 1.6 mm，FR-4，绿油白字，喷锡（有铅/无铅都可） |
| 安装孔 | M3 × 4（四角，Ø3.2 mm） |
| 主控 | Arduino Nano（**插在 2×15 排母上，不焊**，坏了可换） |
| 光耦 | AQY221R2V ×14（SOP-4 贴片，SMT 代贴） |
| 限流电阻 | 1 kΩ ×14（0603 贴片） |
| 接口端子 | 5.08 mm 螺钉端子 ×7 组（电源1 + 器件4 + 万用表1 + 母线1） |

### 3.2 分区与隔离带（这块板的**核心设计**）

```
   ┌─────────────────────────┬──╫──┬──────────────────────────┐
   │      控制侧（左侧约58mm）│隔║离│  测量侧（右侧约38mm）     │
   │  · Arduino Nano 排母     │带║  │  · 光耦输出侧             │
   │  · 14 只 1kΩ 限流电阻    │  ║  │  · 母线 HI / LO           │
   │  · 光耦 LED 侧           │  ║  │  · 器件端子 ch1~ch4       │
   │  · 5V 电源 + GND 铜箔    │  ║  │  · 万用表端子 I/V/COM     │
   └─────────────────────────┴──╫──┴──────────────────────────┘
                            14 只光耦横跨这里，引脚天然分居两侧
```

**设计要点**：

1. **14 只光耦横向排列、跨在隔离带上**：SOP-4 的 1/2 脚（LED 侧）在控制侧，3/4 脚（输出侧）在测量侧——光耦本身就是隔离器件，让它骑在隔离带上，**两侧铜箔永不连通**；
2. **隔离带无铜**：宽约 **2~3 mm**，禁止任何走线、覆铜、过孔跨越；
3. **控制侧底层整片覆铜接 GND_CTRL**（抗干扰）；
4. **测量侧不覆铜**（保持浮空、干净）——μA/mV 级测量最怕漏电通路和地环路；
5. 控制侧与测量侧**各自独立**，全板唯一跨隔离带的元件就是那 14 只光耦。

### 3.3 元件清单（BOM，含位号）

| 位号 | 元件 | 封装 | 数量 | 备注 |
|---|---|---|---|---|
| U1 ~ U14 | **AQY221R2V**（PhotoMOS 光耦） | SOP-4 | 14 | U1/2/3=ch1，U4/5/6=ch2，U7/8/9=ch3，U10/11/12=ch4，U13/14=模式耦合器 |
| R1 ~ R14 | 1 kΩ ±1% | 0603 | 14 | 每只 LED 各一只 |
| X1, X2 | 2×15P 圆孔排母（2.54 mm） | 直插母座 | 2 | 插 Arduino Nano |
| J1 | 电源 5V/GND | 5.08 mm 2P | 1 | 1=+5V，2=GND_CTRL |
| J2 ~ J5 | 器件 ch1~ch4 | 5.08 mm 2P | 4 | 1=A 端，2=B 端 |
| J6 | 万用表 | 5.08 mm **3P** | 1 | 1=I（电流），2=V（电压），3=COM |
| J7 | 母线（调试用） | 5.08 mm 2P | 1 | 1=BUS_HI，2=BUS_LO |
| C1 ~ C4 | 100 nF 去耦 | 0603 | 4 | 靠近 Nano 电源脚 |
| H1 ~ H4 | 安装孔 | M3（Ø3.2） | 4 | 四角 |

### 3.4 网络表（NET）——这是你画原理图的依据

**控制侧网络**

| 网络名 | 连接的引脚 |
|---|---|
| `D2` | X1-D2、R1-1、R2-1 |
| `D3` | X1-D3、R3-1 |
| `D4` | X1-D4、R4-1、R5-1 |
| `D5` | X1-D5、R6-1 |
| `D6` | X1-D6、R7-1、R8-1 |
| `D7` | X1-D7、R9-1 |
| `D8` | X1-D8、R10-1、R11-1 |
| `D9` | X1-D9、R12-1 |
| `D10` | X1-D10、R13-1 |
| `D11` | X1-D11、R14-1 |
| `LED1` … `LED14` | R1-2→U1-1、R2-2→U2-1、……、R14-2→U14-1（14 条独立网络） |
| `GND_CTRL` | X1-GND、J1-2、C1~C4 的 GND 端、**U1-2 ~ U14-2（14 只光耦的 LED 阴极）** |
| `+5V` | X1-5V、J1-1、C1~C4 的 +端 |

**测量侧网络**

| 网络名 | 连接的引脚 |
|---|---|
| `BUS_HI` | U1-4、U4-4、U7-4、U10-4（4 只选通A 的输出）、U13-3、U14-3、J7-1 |
| `BUS_LO` | U2-4、U5-4、U8-4、U11-4（4 只选通B 的输出）、J6-3（COM）、J7-2 |
| `CH1_A` | U1-3、U3-3、J2-1 |
| `CH1_B` | U2-3、U3-4、J2-2 |
| `CH2_A` | U4-3、U6-3、J3-1 |
| `CH2_B` | U5-3、U6-4、J3-2 |
| `CH3_A` | U7-3、U9-3、J4-1 |
| `CH3_B` | U8-3、U9-4、J4-2 |
| `CH4_A` | U10-3、U12-3、J5-1 |
| `CH4_B` | U11-3、U12-4、J5-2 |
| `DMM_I` | U13-4、J6-1 |
| `DMM_V` | U14-4、J6-2 |

> **对照检查**：`BUS_HI` 只接"选通A"的输出和模式耦合器的输入侧；`BUS_LO` 只接"选通B"的输出和万用表公共端。接错了就是串扰或测不出来。

### 3.5 布局方案

见配套图 **《10-四路板PCB布局图.svg》**（俯视图，带尺寸与位号）。要点：

| 区域 | 位置 | 内容 |
|---|---|---|
| 左上 | x 5~16, y 3~11 | J1 电源端子 |
| 左侧中部 | x 8~46, y 24~40 | X1/X2 排母（Arduino Nano，**USB 口朝板外**） |
| 隔离带左侧 | x 48 一列 | R1~R14（每只与对应的光耦同高） |
| **隔离带** | **x 58~62（无铜）** | — |
| 隔离带上 | x 56~64，竖排 14 只 | **U1~U14 横跨隔离带** |
| 隔离带右侧 | x 65~78 | 母线走线（BUS_HI / BUS_LO 两条主干） |
| 右侧 | x 80~91 | J2~J5 器件端子（竖排 4 组） |
| 右下 | x 78~93, y 66~74 | J6 万用表 3P 端子 |
| 右上 | x 78~93, y 3~11 | J7 母线端子（调试用） |
| 四角 | — | H1~H4 安装孔 |

### 3.6 布线规则

| 类别 | 线宽 | 说明 |
|---|---|---|
| 控制信号（D2~D11、LED1~14） | 0.25 mm | 电流只有 3.75 mA，细线足够 |
| 电源（+5V、GND_CTRL） | 0.8 mm | 14 只 LED 合计约 60 mA |
| **测量线（BUS_HI/LO、CH*_A/B、DMM_I/V）** | 0.5 mm | 电气上不需要粗，但**走线要短、要远离控制线** |
| 过孔 | 0.3/0.6 mm | 尽量少用在测量侧 |

**额外规则**：
- 测量侧走线**避免与任何控制走线平行长距离**（防耦合）；必须交叉时**垂直交叉**；
- 测量侧**不做覆铜**，只在走线周围留出干净的空白；
- 控制侧底层覆铜接 `GND_CTRL`，**但绝不允许覆铜伸进隔离带与测量侧**；
- 器件 A/B 两条线**尽量等长、并行**（双绞思路，减少环路面积）。

### 3.7 丝印标注（打板时一起印，方便装配与排查）

- 每只光耦旁印 **`U1`~`U14`**，并加一行小字 `ch1-A / ch1-B / ch1-SHORT` 等用途；
- 排母旁印 **`Nano（USB朝外）`**；
- 端子旁印 **`J1 5V`、`J2 ch1 A/B`、`J6 DMM I/V/COM`、`J7 BUS HI/LO`**；
- 隔离带位置印 **`═══ 隔离带 勿跨线 ═══`**；
- 板边印板名与版本：**`4CH-IV-Meter v1.0`**。

---

## 四、从零到打板的操作步骤（立创EDA）

| 步骤 | 操作 |
|---|---|
| ① 建工程 | 立创EDA → 新建工程 `4CH-IV-Meter` |
| ② 画原理图 | 从"元件库"搜索并放置：`AQY221R2V`、`1kΩ 0603`、`2×15P 排母`、`5.08mm 2P/3P 端子`、`Arduino-Nano`（有的库里有现成符号） |
| ③ 连线 | **照 §3.4 的网络表连**。技巧：不用拖长线，用**网络标签（Net Label）**，同名即同网络，图会清爽很多 |
| ④ 转 PCB | 菜单"设计 → 转换为 PCB"，元件会带着飞线一起过来 |
| ⑤ 画板框 | 100×80 mm 矩形（工具栏"板框"），四角放 4 个 M3 安装孔 |
| ⑥ 布局 | 照配套图《9-四路板PCB布局图.svg》摆件；**先把 14 只光耦排在隔离带上**，其余围绕它摆 |
| ⑦ 布线 | 先电源、再控制、最后测量（测量线最短最优）。设置好 §3.6 的线宽规则 |
| ⑧ 覆铜 | 底层覆铜 → 网络选 `GND_CTRL` → **手动挖掉隔离带与测量侧区域** |
| ⑨ DRC 检查 | 跑一次设计规则检查，确认无短路、无间距违规 |
| ⑩ 下单 | "PCB 下单" → 选 **2 层 / 1.6mm / 5 片 / 绿油白字 / 喷锡** → 同时勾选 **SMT 贴片**（上传 BOM 与坐标文件，让嘉立创把 14 只光耦 + 14 只电阻 + 去耦电容贴好） |

**费用预估**：PCB 打样 5 片约 5~30 元 + SMT 工程费 50~100 元 + 元件费（14 只 AQY221R2V ≈ 60~90 元 + 阻容 ≈ 5 元）+ 运费 ≈ **合计 150~250 元**。

---

## 五、诚实说明：我能做到哪一步

| 事项 | 我能否直接完成 |
|---|---|
| 设计规格（尺寸、分区、隔离带、布线规则、丝印） | ✅ **已完成**（本文档） |
| **网络表**（等价于原理图的连线信息） | ✅ **已完成**（§3.4） |
| **布局图**（俯视，元件位置与接口朝向） | ✅ **已完成**（配套图《10-四路板PCB布局图.svg / .png》） |
| 生成可直接打板的 **Gerber** | ❌ 不能：需要厂家封装库、精确布线与 DRC 验证，手工生成的文件**打板必出错**（板厂不会帮你改） |
| 生成 **KiCad/立创EDA 工程文件** | ⚠️ 不建议：格式复杂，我手写出来很可能在你机器上**打不开或封装错位**，反而耽误时间 |
| 在立创EDA 里"照规格画出来" | ✅ 你可以：有网表 + 布局图，**1~2 小时能画完**（多数时间是点选元件） |

**最稳妥的路径**：拿本文档 + 布局图，在立创EDA 里画；画完把原理图/PCB 截图发我，我帮你**逐条核对**（网络有没有接错、隔离带有没有被铜皮跨过、端子定义对不对）。

---

## 六、一句话总结

> **PCB 打板** = 把画好的板子文件交给工厂生产出来（打样 5 片约 5~30 元，3~5 天）。
> **软件** = 立创EDA（免费、中文、一键下单 + SMT 代贴）。
> **四路板** = **100×80 mm、2 层**；核心是**14 只光耦横跨隔离带**，左侧控制、右侧测量，两侧铜箔永不连通；网络表、布局、布线规则、丝印均已在上文给出。
