guilinbai/iv-measurement/15-上位机软件方案.md

# 上位机软件方案（计划稿 · 待你确认）

> 目标：4 路器件的**电压图 + 电流图**，横轴统一时间；可扩温湿度；**连续跑 7 天不卡顿**；断电不丢数据。
> 本文只讲方案与取舍，**不含代码**。

---

## 0. 一句话总览

```
   ┌─ DMM6500 #1（常驻电压档）─┐
   │                            │      ┌──────────────────────────────┐
   │                            ├─────▶│ 上位机 Python                │
   │  ┌─ DMM6500 #2（常驻电流档）│      │  · 调度器（采样间隔在这里设）│
   │  │                          │      │  · 采集线程 ×2（两台表）      │
   │  │   ┌─ Arduino Nano ──────┤      │  · 温湿度线程（可选）         │
   │  │   │  （只做时序"手臂"）  │      │  · SQLite 落盘（WAL）        │
   └──┴───┴──────────────────────┘      │  · 界面：两张图 + 降采样绘图  │
                                        └──────────────────────────────┘
```

**核心思想三条**：
1. **Arduino 只当"手臂"**（按时序拨开关），**PC 当"大脑"**（决定什么时候测、存哪、怎么画）；
2. **所有数据的时间戳只有一个来源：PC**（这样两张图才能共用一根时间轴）；
3. **原始数据全部落盘，内存里只留"够画图的那几千个点"**（7 天不卡的关键）。

---

## 1. 需求与约束

| 项 | 内容 |
|---|---|
| 硬件 | Arduino Nano（已跑通 4 路扫描）+ **两台 DMM6500** |
| 测量 | 4 路 × (Voc + Isc)，两台表各管一种 |
| 显示 | **电压图**（4 条曲线）+ **电流图**（4 条曲线），共用统一时间横轴 |
| 扩展 | 后续加温度/湿度，同一时间轴 |
| 连续性 | 连续 **7 天**，界面不能卡 |
| 存储 | 自动存储，**断电后数据可恢复/可查** |
| 采样间隔 | 几百 ms ~ 几百 s，可配 |

---

## 2. 【你的问题】采样间隔设在哪里？→ **建议设在界面上**

采样节奏其实是**三层不同的参数**，不该混在一起：

| 层 | 参数 | 建议设置位置 | 理由 |
|---|---|---|---|
| ① **微时序**<br>（开关动作间隔） | `T_OPEN` / `T_SETTLE` / `T_DWELL` / `T_OFF` | **Arduino 固件里** | 这是**硬件特性**：取决于光耦动作时间、器件电容、万用表响应。属于"调好了就别动"的参数 |
| ② **采样间隔**<br>（每隔多久测一轮） | 如 5 s / 30 s / 5 min | ✅ **上位机界面上** | ① 改一次不用重新烧固件；② 七天里可能想变（白天密、夜间疏）；③ **上位机是唯一时钟来源**，由它掌握最自然 |
| ③ **界面刷新率** | 1~5 Hz | 上位机界面（高级选项） | 只影响画面观感，**不影响数据** |

### 为什么采样间隔必须放上位机（而不是 Arduino）

| 如果放 Arduino | 如果放上位机 |
|---|---|
| 想改间隔 → 要关串口、改代码、重新上传 | 界面输入框改一下，立刻生效 |
| Arduino 自作主张跑，PC 只能被动跟随 → 时间戳受串口延迟影响 | PC 主动发"测第 n 轮" → **时间戳由 PC 在触发瞬间打**，精度达毫秒 |
| 两台表 + 温湿度的节奏要各自对齐，容易错位 | **一个调度器统管所有数据源** → 天生共轴 |
| 模式切换（只测 Voc / 只测 Isc / both）要改固件 | 界面上一勾就行 |

**具体做法**：Arduino 固件里的 `T_INTERVAL` **保留但设成 0**（或在"上位机模式"下不生效）——它只用于**脱机自测**（不接 PC 时确认接线）。正式跑的时候，**Arduino 等 PC 的命令**。

---

## 3. 【架构澄清】两台 DMM6500 怎么配合

### ⚠️ 一个必须先明确的物理约束

**同一个器件的 Voc 和 Isc 不可能同时测**：

```
器件 ──┬── 电压表（高阻 10 GΩ）  → 测到开路电压 Voc ✓
       └── 电流表（近短路 1 Ω）   → 电流表会把器件电压拉成 ~0 ✗
```

接在一起 = 两台表并联 = **电流表把电压表旁路** → Voc 读数变成 ≈ 0（就是之前模式耦合器互锁要防的那件事）。

**所以：四个通道的电压和电流，仍然是"分时"测量的**，两台表的价值不在"同时"，而在下面这点。

### 两台表的真正价值：**省掉"换档 + 等稳定"**

| | 单台表方案 | **两台表方案（你的方案）** |
|---|---|---|
| 表的功能切换 | 每轮要发 `SENS:FUNC "VOLT"/"CURR"`，切完还要等内部继电器稳定（几十~几百 ms） | **表常驻自己档位，一次都不用切** ✅ |
| 耦合器切换 | 切模式耦合器 | 还是切（但只切"谁接母线"） |
| 量程 | 两种模式共用量程 | 各表独立设量程/NPLC，互不干扰 ✅ |
| 测量精度 | 切换瞬间状态不确定 | 表始终处在最佳状态 ✅ |

**结论**：硬件接线不用大改 —— 把原方案里的两个模式耦合器，分别接到两台表上：

```
母线 HI ──┬─ 光耦-13（模式耦合器·电流）── DMM#2 电流端口（常驻电流档）
          └─ 光耦-14（模式耦合器·电压）── DMM#1 电压端口（常驻电压档）
母线 LO ────────────────────────────── 两台表的公共端（黑）
```

> ⚠️ 注意：**两台表的 COM/LO 会接在一起**（都接母线 LO）。这是允许的（同一参考点），但要确认两台表的 LO 没有"反相接地"问题；必要时用**LAN 隔离**或确认表是浮地设计。

### 两种调度方式（界面可切换）

| 方式 | 一轮做什么 | 一轮最短耗时 | 适合 |
|---|---|---|---|
| **A. 单模式轮** | 每轮只测一种（Voc **或** Isc），两种模式交替若干轮 | 4 次 × 200 ms ≈ **0.8 s** | 想要两种曲线都密；间隔可小到 2 s |
| **B. 双模式轮** | 每轮把 4 路的 Voc 和 Isc 都测一遍 | 8 次 × 200 ms ≈ **1.6 s** | 想要"同时刻的 V 与 I 配对"（算功率/IV 点） |

> **硬约束**：方式 B 下**采样间隔不能小于 2 秒**（否则一轮都跑不完）。方式 A 下最小约 1 s。

---

## 4. 系统架构总图

```
┌──────────────────────────── 上位机（Python，单进程多线程）───────────────────────────┐
│                                                                                       │
│  ┌───────────────┐                                                                   │
│  │ 调度器         │  ← ★ 采样间隔在这里（界面参数）                                    │
│  │ Scheduler      │     · 维护"下一次该测什么"的时间表                                │
│  │ (主时钟)       │     · 唯一的时间权威（所有时间戳由它/采集线程打）                  │
│  └───────┬───────┘                                                                   │
│          │ 命令：本轮测 ch_n / 模式 = Isc|Voc                                          │
│          ▼                                                                            │
│  ┌───────────────┐   "WIN ch1 I"   ┌──────────────────────────────────────────┐      │
│  │ 串口线程       │◀────────────────│ 采集线程池                                │      │
│  │ (Arduino)     │────────────────▶│  · 线程1: DMM#1 读电压 (pyvisa, LAN/USB)  │      │
│  └───────────────┘   同步点/窗口   │  · 线程2: DMM#2 读电流                    │      │
│                                    │  · 线程3: 温湿度（可选，PC 直连 USB）     │      │
│                                    └───────────────┬──────────────────────────┘      │
│                                                    │ (ts, src, ch, value)             │
│                                                    ▼                                 │
│                        ┌───────────────────────────────────────────┐                 │
│                        │ 数据总线：内存环形缓冲 + 写入队列          │                 │
│                        │ （定长，绝不无限增长）                     │                 │
│                        └───────┬───────────────────────┬───────────┘                 │
│                                │                       │                             │
│                     ┌──────────▼─────────┐   ┌─────────▼──────────────┐              │
│                     │ 存储线程            │   │ UI 刷新（QTimer 定时）  │              │
│                     │ · SQLite WAL 批量写 │   │ · 多分辨率聚合查询      │              │
│                     │ · 定期 flush/fsync  │   │ · 降采样到像素级再画    │              │
│                     │ · 按天滚动文件      │   │ · 限帧 2~5 fps          │              │
│                     └────────────────────┘   └────────────────────────┘              │
└───────────────────────────────────────────────────────────────────────────────────────┘
```

**五条设计原则**（都是为了 7 天不卡）：
1. **采集与显示彻底解耦**：采集线程只把数据丢进队列，UI 从不等待 IO；
2. **串口/网络操作全部在子线程**：UI 线程绝不碰串口和 VISA；
3. **内存定长**：环形缓冲 + 队列都有上限，满了就丢最旧（数据已落盘，不影响）；
4. **落盘批量 + WAL**：攒够一批再写，断电也不损坏；
5. **画图前先降采样**：绘图点数与"总数据量"无关，只与屏幕宽度有关。

---

## 5. 数据流与线程模型（防卡顿的根基）

| 线程 | 职责 | 关键约束 |
|---|---|---|
| **主线程（UI）** | 只做画图、响应按钮 | **绝不阻塞 >50 ms** |
| **调度线程** | 按间隔到点发命令 | 用 `time.monotonic()` 计时，避免系统时间跳变 |
| **串口线程** | 与 Arduino 收发 | 读超时可配；掉线自动重连 |
| **DMM 线程 ×2** | 两台表读数 | 各自独立；一个卡住不影响另一个（但要设超时） |
| **温湿度线程** | 可选，PC 直连 USB 模块 | 与测量无关，独立节奏（如每 10 s 一次） |
| **存储线程** | SQLite 批量写 + flush | 队列满时**优先保数据**（可阻塞采集，或写临时文件） |

**同步点怎么做**（关键细节）：
```
调度器  ──"测 ch1，Isc"──▶  串口线程 ──▶ Arduino
Arduino 执行微时序，到"读数窗口"开头时打印：  WIN CH1 I
串口线程收到  ──▶  立刻放一个"触发令牌"进队列 + 记录 ts_trigger = time.time()
DMM#2 线程收到令牌  ──▶  发 :READ?  ──▶  得到电流值
（电压图同理：WIN CH1 V → DMM#1 线程读数）
两条记录共用同一个 ts_trigger  → 两张图天生共轴 ✅
```

> **为什么用"窗口"而不是"精确延时"**：串口有随机延迟（几 ms），用"Arduino 报窗口 → PC 立刻读"的方式，实际测量时刻由 **PC 的时间戳**决定，与串口延迟无关。

---

## 6. 数据存储方案（7 天断电不丢）

### 6.1 数据量实算（已算好）

| 采样间隔 | 7 天轮数 | 数据点（both + 温湿度） | SQLite 体积 |
|---|---|---|---|
| 0.5 s | 121 万 | 1210 万 | ~520 MB |
| **1 s** | **60 万** | **605 万** | **~260 MB** |
| 2 s | 30 万 | 302 万 | ~130 MB |
| 5 s | 12 万 | 121 万 | ~52 MB |

**结论：完全可控**（几百 MB 级）。真正的坑不是磁盘，而是"把 600 万点塞进内存画图" ✗

### 6.2 存储技术选择

| 方案 | 断电安全 | 查询速度 | 可读性 | 建议 |
|---|---|---|---|---|
| **CSV 追加写** | 差（正在写的行可能截断） | 差（每次都全文件扫） | ✅ Excel 直接开 | 作为**导出格式**，不作为主存储 |
| **SQLite（WAL 模式）** | ✅ **断电不损坏** | ✅ 带索引，毫秒级 | 需工具查看 | ✅ **主存储** |
| 二进制 + 自写索引 | ✅ | ✅ 最快 | ✗ 要自带工具 | 数据量 >10 GB 才考虑 |

**推荐：SQLite（WAL）作主存储 + 一键导出 CSV**（两者兼得）

### 6.3 表结构（草案）

```sql
-- 测量数据（4 路 × V/I）
samples(ts REAL, run_id INT, ch INT, mode TEXT, value REAL, unit TEXT, quality INT)
  索引: (ts), (ch, mode, ts)

-- 环境数据（温/湿，可扩）
env(ts REAL, sensor TEXT, value REAL, unit TEXT)
  索引: (ts), (sensor, ts)

-- 每次"运行"的配置（便于回溯"这批数据是用什么参数测的"）
runs(id INT PRIMARY KEY, start_ts REAL, end_ts REAL, config_json TEXT)

-- 事件日志（断线、重连、模式切换、异常值）
events(ts REAL, level TEXT, src TEXT, msg TEXT)

-- ★ 多分辨率聚合表（7 天不卡的关键，见 §8）
agg_1min(bucket_ts INT, ch INT, mode TEXT, v_min REAL, v_max REAL, v_avg REAL, n INT)
agg_1hour(bucket_ts INT, ch INT, mode TEXT, v_min REAL, v_max REAL, v_avg REAL, n INT)
```

### 6.4 断电安全的具体做法

| 措施 | 说明 |
|---|---|
| **WAL 模式** | `PRAGMA journal_mode=WAL` —— 崩溃/断电时数据库不会损坏（最多回滚最后一个未提交事务） |
| **批量提交** | 攒 50~200 行或每 1~2 秒 `commit` 一次（频繁单条提交会拖慢并增加风险） |
| **同步级别** | `PRAGMA synchronous=NORMAL`（WAL 下已足够安全，比 FULL 快很多） |
| **按天分库** | 如 `data_2026-10-30.db`，避免单文件过大、便于归档 |
| **启动自检** | 每次启动跑一次完整性检查；发现异常自动切到新文件并记录事件 |
| **可选加分项** | 给 PC 加个**小 UPS**（¥100 级）→ 断电时能优雅收尾 |

> 📌 **"断电自动存储"的准确含义**：数据是**边测边写**的，不是"断电那一刻才存"。所以断电后**最多丢最后 1~2 秒**，其余全部完好。这正是 WAL + 批量提交要达到的效果。

---

## 7. 界面设计

### 7.1 布局线框（建议）

```
┌──────────────────────────────────────────────────────────────────────────────┐
│ [开始] [停止] [导出CSV]   运行状态: ● 采集中   已运行: 2天03时11分   间隔[ 5 ]s │
├──────────────────────────────────────────────────────────────────────────────┤
│  电压 Voc (V)                                              时间范围:          │
│   2.0┤      ╭─╮        ╭──╮                    ╭─╮       ( )10分 (•)1时     │
│      │  ╭───╯ ╰──╮  ╭──╯  ╰──╮             ╭──╯ ╰─╮       ( )1天 ( )7天      │
│   1.0┤──╯        ╰──╯         ╰─────────────╯      ╰──    [ ]自动跟随最新      │
│      │  ch1 ── ch2 ── ch3 ── ch4 ──                                        │
│   0.0└──────────────────────────────────────────────────────────────────────│
├──────────────────────────────────────────────────────────────────────────────┤
│  电流 Isc (mA)                                                               │
│  10.0┤   ╭╮  ╭╮   ╭╮   ╭╮        ╭╮   ╭╮                                   │
│      │  ╭╯╰╮╭╯╰╮ ╭╯╰╮ ╭╯╰╮      ╭╯╰╮ ╭╯╰╮                                 │
│   5.0┤──╯   ╰╯   ╰╯   ╰╯   ╰────╯   ╰╯   ╰───                              │
│      │  ch1 ── ch2 ── ch3 ── ch4 ──                                        │
│   0.0└──────────────────────────────────────────────────────────────────────│
├──────────────────────────────────────────────────────────────────────────────┤
│  环境（预留）                                                                │
│  30℃┤      ╱╲      ╱╲          [ ]显示温度  [ ]显示湿度  [ ]显示功率(需双表配对)│
│  20℃└─────╱──╲────╱──╲────                                                  │
├──────────────────────────────────────────────────────────────────────────────┤
│ 采集: 固定全扫 4 路 × (V+I) = 8 项/轮   本轮耗时 1.16 s / 间隔 2.00 s ✓ 裕量 0.84 s │
│ 数据源: DMM#1(电压)=USB0::...  DMM#2(电流)=USB0::...  Arduino=COM9  温湿度=[未启用] │
│ 日志: 12:03:11 CH1 V=1.4231V  I=9.87mA  |  CH2 V=...  |  12:03:13 ...              │
└──────────────────────────────────────────────────────────────────────────────┘
```
> 图例上的通道名可**点击隐藏/显示**某条曲线（只影响画面，不影响采集与存储）。

### 7.2 设计要点

| 需求 | 做法 |
|---|---|
| **统一时间横轴** | 两个（三个）图都用同一个"时间戳"字段；用绘图库的 **X 轴联动**（缩放/平移同步） |
| 4 条曲线辨识 | 固定配色 + 图例；可单独勾选显示/隐藏某一路 |
| 时间范围切换 | 10 分钟 / 1 小时 / 1 天 / 7 天 四档（对应四张聚合表/原始表） |
| 自动跟随 | "自动跟随最新"勾上时，视窗右端始终跟着最新数据滚动 |
| 温度/湿度 | 独立第三个子图（高度小），**预留接口，先不实现** |
| 断点/异常 | 数据缺失处分段绘制（不连线），并在事件区标记 |
| **噪声抑制** | 可选"显示平均值/最小值/最大值带"（用聚合表的 min/max 画 envelope） |

---

## 8. "七天不卡顿"的三个技术关键

### 关键①：绘图前必须降采样（**最重要**）

```
7 天 × 1 s × 4 路 = 242 万个点
如果全画：600 px 宽 → 每像素 4000 点 → 必卡死 ✗

按像素分桶后：每像素 1 个代表点 → 最多 1600 点/曲线 → 恒定流畅 ✓
```

**算法**：最小/最大/平均 分桶（或 LTTB 保形降采样）。**绘图耗时只与屏幕宽度有关，与数据量无关。**

### 关键②：多分辨率聚合表（7 天视图 <10 ms）

写数据时**顺手更新聚合表**：

| 视图 | 数据来源 | 点数 |
|---|---|---|
| 最近 10 分钟 | 原始表 | 600 |
| 最近 1 小时 | 原始表 或 1 分钟聚合 | 60~3600 |
| 最近 1 天 | **1 分钟聚合** | 1440 |
| **最近 7 天** | **1 小时聚合** | **168** ✓ 秒出 |

这样**看 7 天根本不用碰原始表** → 查询毫秒级 ✓✓

### 关键③：限帧 + 增量重绘

| 措施 | 说明 |
|---|---|
| **UI 刷新限帧** | 2~5 fps（人眼看曲线不需要 60 fps）；数据照收不误，只是画面不必每点都重绘 |
| **只更新曲线数据** | 不清屏重画整张图，只 `setData()` 更新曲线 |
| **分块加锁** | 采集线程写环形缓冲、UI 只读 → 用双缓冲/快照，避免长时间持锁 |
| **大视图降级** | 7 天视图只画聚合曲线；放大到 1 小时以内才显示原始点符号 |

---

## 9. 温湿度接入方案对比

| 方案 | 接线 | 隔离性 | 时间对齐 | 建议 |
|---|---|---|---|---|
| **A. 挂到 Arduino（I2C，A4/A5）** | SHT31/AHT20 接 Nano | ⚠️ 传感器若贴近器件，可能把测量侧电位引到控制侧 → **破坏隔离** | 天然与测量同轮 | 只在"传感器远离测量侧"时用 |
| **B. PC 直连 USB 模块**（CH340+SHT31 成品，约 ¥15） | 插 PC 的 USB 口 | ✅ **完全隔离**（PC 侧独立设备） | 用 PC 时间戳，天然共轴 ✅ | ✅ **推荐** |
| **C. 独立记录仪**（电池供电，事后合并） | 独立系统 | ✅✅ 最好 | ⚠️ 要事后按时间戳合并（有时钟漂移风险） | 需要"贴着器件"测温时用 |

**推荐**：先用 **B**（十几块钱、插上就能用、零干扰）；如果以后发现"器件温度 ≠ 环境温度"很重要，再上 C。

**接口预留**：界面里做成**插件式数据源**（`Data source` 接口），以后加温湿度只需实现一个类，不用改采集和绘图代码。

---

## 10. 七天连续运行体检清单

| # | 风险 | 对策 | 优先级 |
|---|---|---|---|
| 1 | PC 自动睡眠 → 采集停摆 | 电源计划设"从不睡眠" + 程序启动时阻止睡眠 | ★★★ |
| 2 | 断电丢数据 | SQLite WAL + 每 1~2 s 提交（最多丢 1~2 s）；**已定不买 UPS**，改用启动续测 + 崩溃自动重启补偿（§14） | ★★★ |
| 3 | 磁盘写满 | 提前估算（260 MB/7天）+ 启动检查剩余空间 + 低空间告警 | ★★☆ |
| 4 | 串口掉线 | 自动重连 + 事件记录 + 界面红点提示 | ★★★ |
| 5 | 表的 USB 掉线 / 重新枚举 | pyvisa 异常捕获 + **按序列号自动识别端口** + 自动重连 + 该点标 `quality=bad` | ★★★ |
| 6 | 内存缓慢增长 | 监控进程 RSS，超阈值记录事件（并检查是否有泄漏） | ★★☆ |
| 7 | 界面卡顿 | 降采样 + 限帧 + 采集与 UI 解耦（§8） | ★★★ |
| 8 | 时间漂移 | PC 定期 NTP 校时；程序内用 `monotonic` 计间隔 | ★☆☆ |
| 9 | 程序崩溃 | 看门狗脚本（崩溃后自动重启并续测） | ★★☆ |
| 10 | 数据可追溯 | 把每轮参数写进 `runs.config_json`（以后能回答"这批数据当时怎么设的"） | ★★☆ |

---

## 11. 已确认的决策（定稿）

| # | 项目 | **你的决定** | 由此带来的实施要点 |
|---|---|---|---|
| 1 | 采样间隔位置 | ✅ **界面上设** | 固件 `T_INTERVAL` 设为 0；PC 主控 |
| 2 | 两台表连接 | ✅ **USB** | ⚠️ USB 会重新枚举（拔插后 COM 口可能变）→ 必须做**端口自动识别 + 重连**，配置里存**序列号**而不是 COM 号 |
| 3 | 调度方式 | ✅ **固定全扫**（每轮 4 路 × V+I = 8 项，不做通道选择） | 见 §12；按模式分组执行，耦合器一轮只切 2 次 |
| 4 | 采样间隔 | ✅ 先按 **2 s**，界面可改 | 2 s 是"周期"（相邻两轮开始时刻之差）；配 §12 的**间隔保护** |
| 5 | IV / 功率视图 | ✅ **先不做，留数据接口** | 数据已带 `(ts, ch, mode)`，将来按时间戳配对即可 |
| 6 | 温度 | ✅ **环境温度** → PC 直连 USB 模块（方案 B） | 完全隔离、零干扰；插件式数据源接口 |
| 7 | UPS | ✅ **不买** | 用软件措施补偿：WAL + 1~2 s commit + 启动续测 + 崩溃自动重启（见 §10） |
| 8 | 数据保留 | ✅ **按天分库，全部保留** | 命名 `data_YYYY-MM-DD.db`；7 天约 260 MB，磁盘无压力 |
| 9 | 数据导出 | ✅ **自动导出**（忘了点也不怕） | 采用 §13 的"**实时 CSV 副本**"方案：边测边写，关闭时只做校验补齐（秒级）；崩溃/断电也有完整副本 |
| 10 | 存储目录 | ✅ **界面可选**，按日期自动命名 | §13.3/13.4：目录可浏览更改、自动创建；文件名 **`YYYY-MM-DD`（零填充）** 保证排序正确；按天建子文件夹 |

---

## 12. 采集范围：**固定全扫**（4 路 × V+I = 每轮 8 项）

> **定稿（改主意后）**：**不做"每通道可选测什么"**。每一轮**固定把 4 路的电压和电流都测一遍**（8 项）。
> 某路如果空着，数据照测；**事后在后处理时按通道筛掉即可。**

### 12.1 这样做的好处

| 好处 | 说明 |
|---|---|
| 界面少一个配置面板 | 只剩"采样间隔"一个输入框，不容易误操作 |
| 调度逻辑最简单 | 每轮固定 8 项、固定顺序 → 时间表可预测、容易验证 |
| 数据规整 | 每轮都是完整的 8 个值，后处理只要按 `ch` 筛 |
| 固件命令简化 | 一条 `S` 命令 = 扫一轮，不用传参数 |
| 未来扩展友好 | 想加"只测部分通道"随时能加（固件已按参数化设计，见下） |

### 12.2 固件 v1.1：一条 `S` 命令扫一轮（**按模式分组**执行）

```
PC ──"S"──▶ 固件
             │
             ├─【第一段·电压】模式耦合器切到电压位（光耦-14 通、光耦-13 断）
             │    for ch = 1..4：
             │        断短接 → 合选通[ch] → 报 "WIN ch V" → 断选通 → 合短接
             │
             ├─【切换】break-before-make（断光耦-14 → 等 10 ms → 合光耦-13）
             │
             ├─【第二段·电流】模式耦合器切到电流位
             │    for ch = 1..4：
             │        断短接 → 合选通[ch] → 报 "WIN ch I" → 断选通 → 合短接
             │
             └─【收尾】耦合器回电压位（为下一轮准备）→ 报 "ROUND DONE"
```

**为什么按模式分组**：耦合器一轮只切 **2 次**（V→I、I→V）。
若按"逐通道 V+I 交替"，每个通道都要切，一轮要切 **8 次** ✗

> 💡 固件仍按"**参数化**"实现（内部有个 `mask[8]` 数组，`S` 默认全 1）。
> 这样将来若要恢复"只测部分"，**PC 发 `S 1101|1001` 即可**，不用改固件。

### 12.3 一轮耗时与**间隔保护**（仍必须做）

单次测量的微时序：
```
T_OPEN(30) + T_SETTLE(80) + 读数窗口(10) + T_OFF(20) ≈ 140 ms
（表用 :READ? 触发读数时，读数本身就是等待，T_DWELL 可省）
```

| 组成 | 耗时 |
|---|---|
| 8 次测量 | 8 × 140 ms = **1120 ms** |
| 耦合器切换 ×2 | 2 × 20 ms = 40 ms |
| **一轮最短耗时** | **≈ 1.16 s** |

| 采样间隔 | 裕量 | 评价 |
|---|---|---|
| **2 s（你的设定）** | **0.84 s** | ✅ **充裕** |
| 1.5 s | 0.34 s | ✓ 可用 |
| 1.2 s | ≈ 0 | ⚠️ 临界 |
| < 1.2 s | 负 | ❌ 跑不完，数据会持续滞后 |

**界面必须做的三件事**：

1. 实时显示：`本轮耗时 1.16 s ／ 间隔 2.00 s ／ 裕量 0.84 s`；
2. 间隔填得过小时 → **红色警告 + 提示最小建议值**（1.4 s = 1.16 × 1.2）；
3. 可选"**自动延长间隔**"（不够就自动取 `耗时 × 1.2`，并写事件日志）。

> 📌 **间隔的定义**：统一用"**周期**"——相邻两轮**开始时刻**之差。
> 若定义成"本轮结束后再等 N 秒"，实际周期会变成 N + 1.16 s，容易误解。

### 12.4 空通道怎么处理（你的做法：后处理筛掉）

采集侧**不做任何过滤**（永远全扫），所以每轮必然有完整的 8 条记录。为了让"筛掉空通道"尽量省事，软件提供这几样：

| 功能 | 说明 |
|---|---|
| 数据带 `ch` 字段 | 每条记录都标明通道 → `WHERE ch IN (1,3)` 一句话筛完 |
| **导出 CSV 时可勾选通道** | 导出时就只写想要的通道，不用"导出后再删" |
| **图例点击隐藏曲线** | 实时看图时，空通道的噪声曲线点一下即可隐藏（**不影响采集与存储**） |
| `quality` 标记 | 读数超量程/明显异常的点打标记，便于批量过滤 |
| 事件表 | 记录配置变更、断线、重连，图上可打竖直标记线，便于对照分析 |

---

## 13. 数据导出与存储目录（自动导出 + 按日期命名）

### 13.1 先说一个隐患：**"只在关闭时导出"不够可靠**

如果程序是**崩溃**或**直接断电**结束的，就没有"关闭"这个时机 → **导出永远不会发生** ✗

所以导出要做成**三个层次**（叠起来才稳）：

| 层次 | 时机 | 作用 | 等待时间 |
|---|---|---|---|
| **① 实时副本**（推荐，默认开） | **边测边追加写 CSV** | 任何时刻磁盘上都有一份完整 CSV；崩溃/断电也不怕 | **0 秒** ✅ |
| **② 定期归档** | 每天 00:05（或跨天时）把前一天文件"结账"：补表头、生成汇总、更新索引 | 文件整洁、便于归档 | 后台，无感 |
| **③ 关闭兜底** | 关闭软件时**校验** CSV 与 SQLite 行数是否一致，缺则补齐 | 兜住"实时副本写入失败"的极端情况 | 通常 <1 秒 |

> 📌 **关键结论**：**有了①，关闭时根本不需要"导出"这个动作**——CSV 一直是最新的。
> 关闭时只做一次**快速校验 + 补齐**，秒级完成 ✓ 这才真正解决"忘了点导出"。

### 13.2 关闭软件时的行为（设计）

```
用户点 [×] 关闭
   │
   ├─ ① 停止采集（Arduino 回安全态、两台表停止取数）
   ├─ ② flush 存储队列（把内存里没落盘的数据写完，通常 <1 s）
   ├─ ③ 校验：SQLite 行数 == CSV 行数？
   │       ├─ 一致 → 直接完成
   │       └─ 不一致 → 补齐缺失行（带进度条，一般几秒内）
   ├─ ④ 写一条 session 结束事件（含起止时间、总行数、文件路径）
   └─ ⑤ 退出
```

**三种特殊情况**：

| 情况 | 处理 |
|---|---|
| 校验/补齐**超过 10 秒** | 弹窗显示进度 + **[继续等待] [跳过并退出]**（数据在 SQLite 里没丢，可事后再导） |
| 补齐**失败**（磁盘满/权限/文件被 Excel 占用） | **不阻止退出**，弹提示：错误原因 + 手动导出入口 + "数据已安全保存在 xxx.db" |
| 磁盘剩余空间**不足** | 启动时就预警；关闭时若空间不足则跳过补齐并提示 |

### 13.3 存储目录设置（界面新增）

界面增加一个"存储"区域：

```
┌ 存储 ─────────────────────────────────────────────────────────────┐
│ 存储目录: D:\IV_data\                              [浏览…] [打开]  │
│ 当前文件: 2026-10-30\2026-10-30.db  (+ .csv 实时副本)              │
│ 磁盘剩余: 182.4 GB ✓        本次已写: 128,400 行 / 24.6 MB         │
│ [✓] 实时写 CSV 副本   [✓] 关闭时校验补齐   [ ] 每天 00:05 归档      │
└───────────────────────────────────────────────────────────────────┘
```

| 控件 | 行为 |
|---|---|
| **存储目录** | 启动时若不存在则**自动创建**；写入前检查可写权限 |
| **浏览…** | 弹文件夹选择框 |
| **打开** | 用资源管理器打开当前目录（方便查看） |
| **运行中改目录** | 允许；**立即在新目录建文件并切换**，旧文件保持完整，同时写一条事件日志 |
| 磁盘剩余 | 实时显示；低于 1 GB 变黄、低于 200 MB 变红并强提示 |
| 实时写 CSV | 默认勾选（见 13.1 的①） |

### 13.4 按日期命名的规则（**排序必须正确**）

**关键：必须零填充**，否则字符串排序 ≠ 时间排序：

| 命名 | 排序结果 | 结论 |
|---|---|---|
| `2026-10-3` / `2026-10-30` | `2026-10-3` 排在 `2026-10-30` **后面** ✗ | ❌ 月份/日不补零 → 排序错乱 |
| **`2026-10-03` / `2026-10-30`** | 正确按时间排序 ✅ | ✅ **采用 ISO 8601 + 补零** |

**目录结构（建议：按天建子文件夹，便于整体拷贝归档）**：

```
D:\IV_data\
├─ 2026-10-30\
│   ├─ 2026-10-30.db             ← SQLite 主存储（当天全部数据）
│   ├─ 2026-10-30_samples.csv    ← 实时副本（测量数据）
│   ├─ 2026-10-30_env.csv        ← 环境数据（温湿度）
│   ├─ 2026-10-30_events.csv     ← 事件日志（断线/重连/配置变更）
│   └─ 2026-10-30_run.json       ← 当天配置快照（可追溯）
├─ 2026-10-31\
│   └─ ...
└─ index.csv                     ← 总索引：每天的时间段、行数、文件清单
```

**CSV 列（测量文件）**：
```
timestamp,iso_time,run_id,ch,mode,value,unit,quality
1759214592.184,2026-10-30 12:03:12.184,17,1,V,1.4231,V,0
1759214592.421,2026-10-30 12:03:12.421,17,1,I,0.00987,A,0
...
```
- `timestamp` = Unix 秒（机器友好、排序稳）
- `iso_time` = 人看的本地时间（含毫秒）
- `quality` = 0 正常、1 可疑、2 无效（断线/超量程）
- **一行一个测量值**（长表格式），而不是"一行一轮、8 列宽表"
  - 长表：加字段不用改表结构、便于筛选、便于追加；
  - 需要宽表时由后处理脚本透视 ✓

### 13.5 手动导出（保留，用于按需导出）

自动副本解决"怕丢"，但有时你想**只导出一部分**（比如只导 ch1 的电压、只导某两天）→ 保留手动导出按钮：

| 选项 | 说明 |
|---|---|
| 时间范围 | 全部 / 今天 / 指定区间 |
| 通道筛选 | ch1~ch4 任意勾选（**空通道在这里一次筛掉**） |
| 模式筛选 | 电压 / 电流 / 两者 |
| 格式 | CSV（长表）/ CSV（宽表，便于 Origin 直接画）/ Excel |
| 输出位置 | 默认同目录 `export_YYYY-MM-DD_HHMMSS.csv`（**带时间戳，避免覆盖正被 Excel 打开的文件**） |

### 13.6 导出失败的处理（三类）

| 失败原因 | 处理 |
|---|---|
| 磁盘空间不足 | 导出前预估大小并检查；不足则提示并允许改目录 |
| 目标文件被占用（Excel 打开着） | 自动改用带时间戳的新文件名，不覆盖 |
| 权限不足 | 提示具体路径与错误码，建议换目录 |

> **原则：导出失败绝不影响采集，也绝不影响退出**。数据在 SQLite 里是安全的，导出只是"另一份拷贝"。

---

## 14. 没有 UPS 时的风险补偿（已定：不买）

| 威胁 | 补偿措施 | 效果 |
|---|---|---|
| 断电瞬间正在写数据 | SQLite **WAL** + 每 1~2 s `commit` | **最多丢 1~2 秒** |
| 断电后不知道测到哪 | 启动时读数据库尾部时间戳/`run_id`，**自动续测** | 无需人工干预 |
| 表设置丢失 | 表侧设置每次启动重发；PC 侧配置存文件 + 写 `runs.config_json` | 可完整复现 |
| 程序崩溃 | 看门狗脚本自动重启 + 续测 | 无人值守可用 |
| 采集断线 | 串口/VISA 异常捕获 + 自动重连；缺口标 `quality=bad`（图上断开不连线） | 数据可辨真伪 |
| PC 睡眠 | 电源计划"从不睡眠" + 程序启动时阻止睡眠 | 防止停摆 |

---

## 15. 分期实施计划

| 阶段 | 内容 | 产出 |
|---|---|---|
| **第 1 期**<br>骨架跑通 | **固件 v1.1**（扫描表命令）+ 单台 DMM + SQLite 落盘 + 一张图 | 能采、能存、能看 |
| **第 2 期**<br>双表双图 | 接入第二台 DMM；**固定全扫节奏 + 间隔保护**；电压/电流两图；统一时间轴 + 联动；时间范围四档 | ✅ 你要的核心功能 |
| **第 3 期**<br>环境量 | 温湿度接入（PC 直连 USB 模块）；第三个子图 | 三图共轴 |
| **第 4 期**<br>长跑加固 | 7 天压力测试、断电恢复验证、崩溃自动重启、CSV 导出 | 可无人值守 |

> 建议**每期都做短跑验证**（如第 2 期跑 2 小时 + 故意拔一次电），别等第 4 期才测稳定性。

---

## 16. 一句话总结

> **采样间隔放界面**（微时序留固件）；
> **两台表各自常驻一个档位**，切换的是"谁接母线"，不是表的档位（Voc/Isc 物理上不能同时测）；
> **采集固定全扫**（4 路 × V+I，每轮 8 项，不做通道选择），空通道留到后处理筛；关键是固件 `S` 命令按模式分组执行、界面做**间隔保护**（一轮最短 1.16 s）；
> **数据边测边落盘**（SQLite WAL，断电最多丢 1~2 秒，无 UPS 也够用）；
> **画图前先降采样 + 多分辨率聚合表**——这是"7 天不卡"的根本，绘图耗时只跟屏幕宽度有关，跟数据量无关。
