guilinbai/iv-measurement/6-单通道接线详图.png

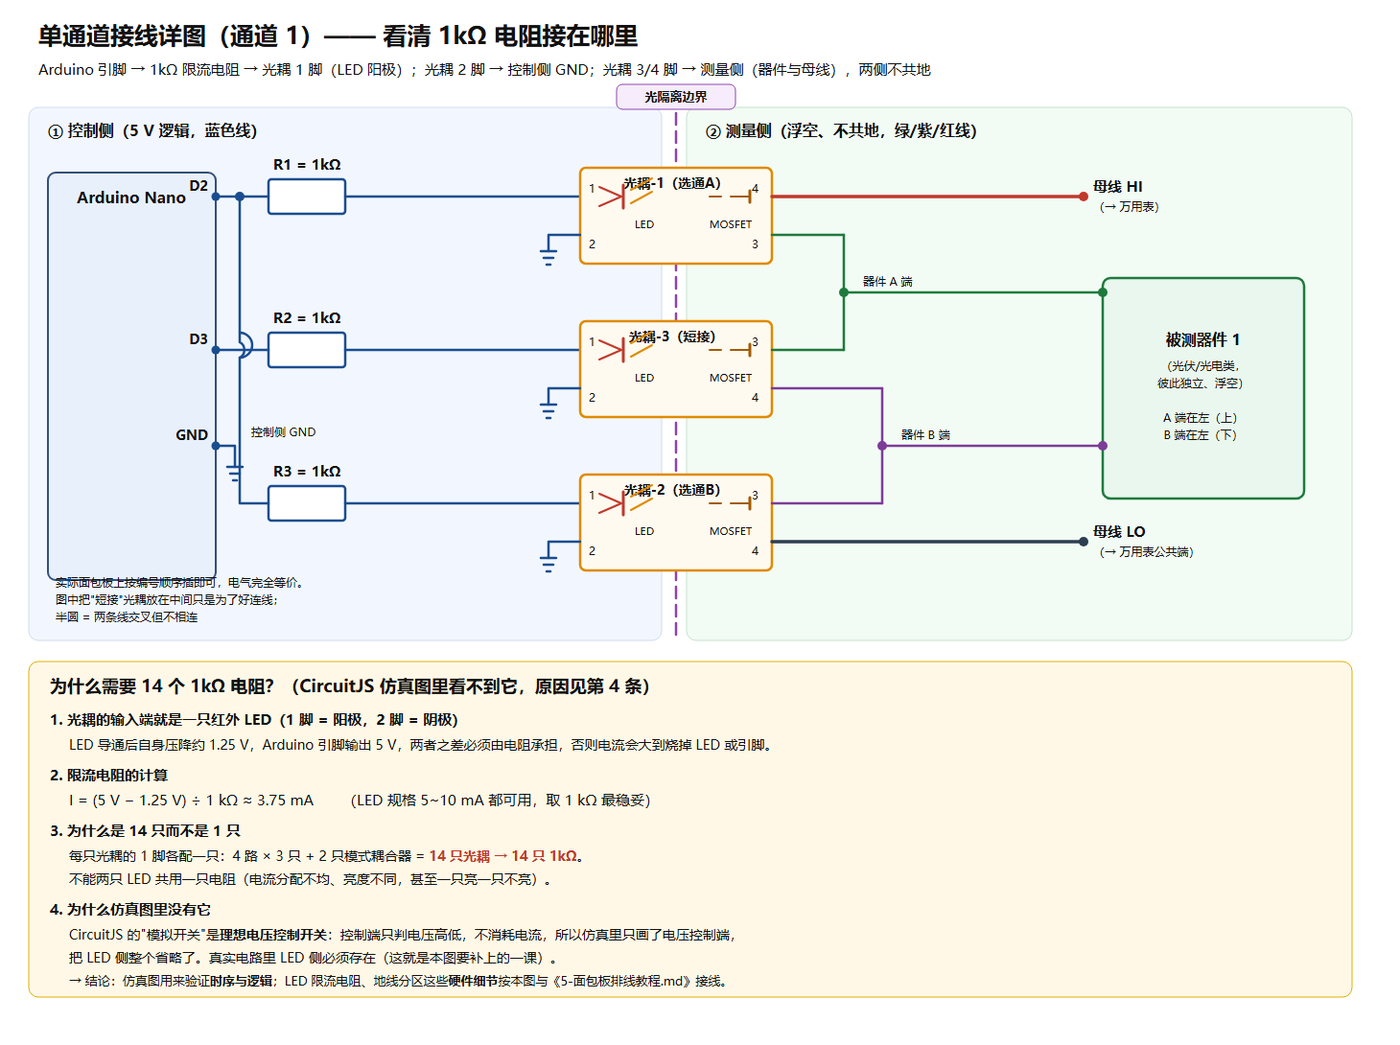
6-单通道接线详图.png
