guilinbai/iv-measurement/7-系统整体结构图.png

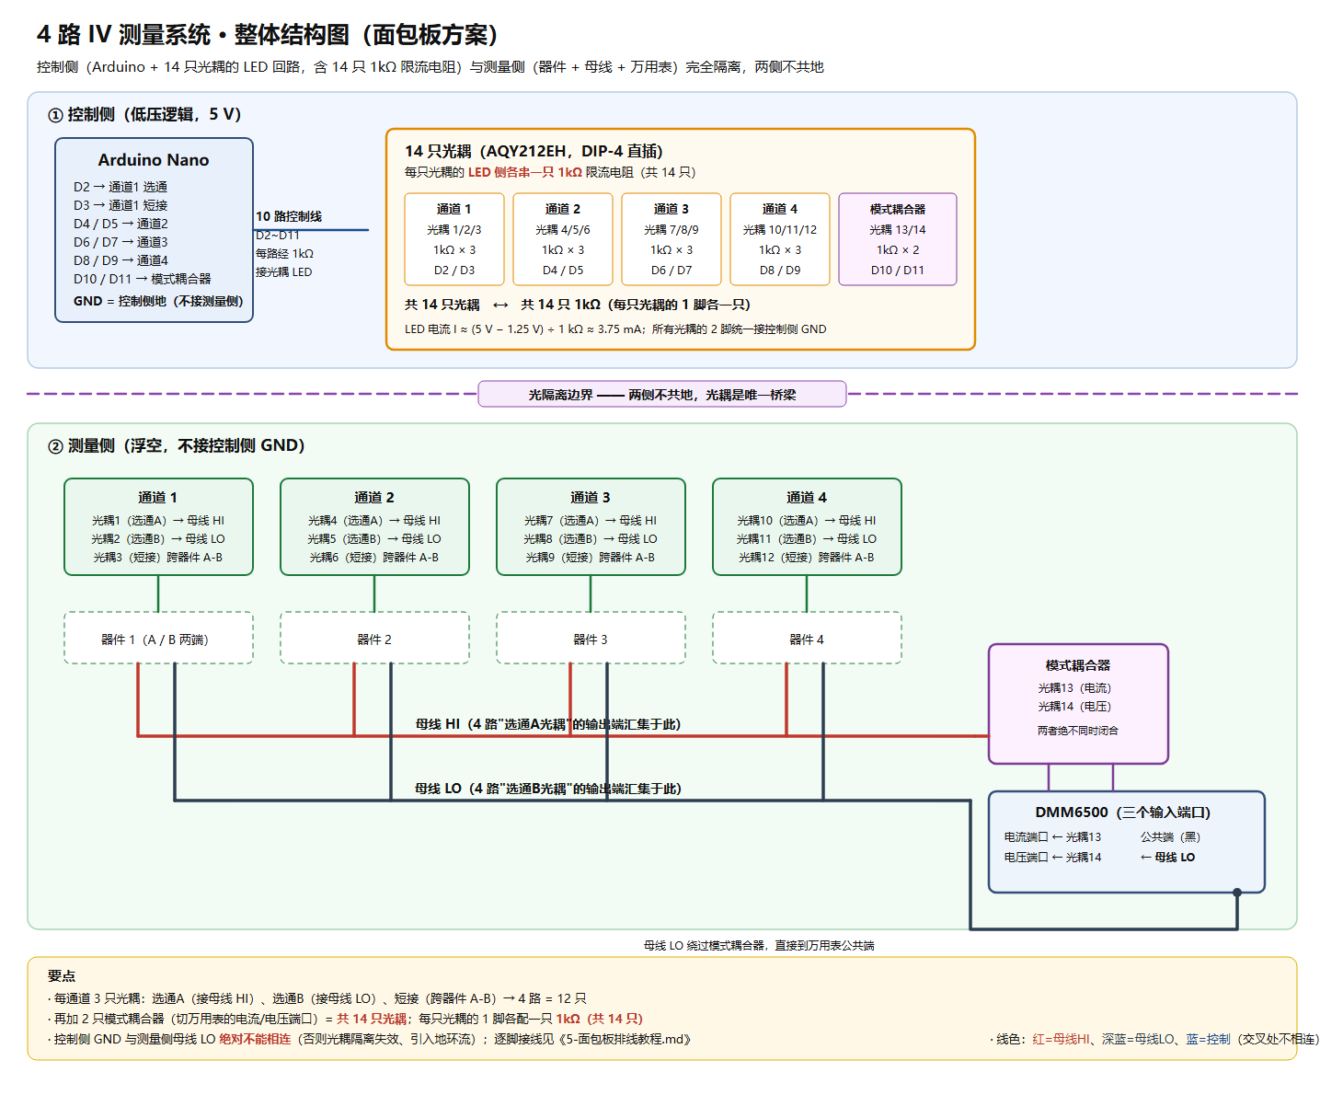
7-系统整体结构图.png
