guilinbai/iv-measurement/10-四路板PCB布局图.png

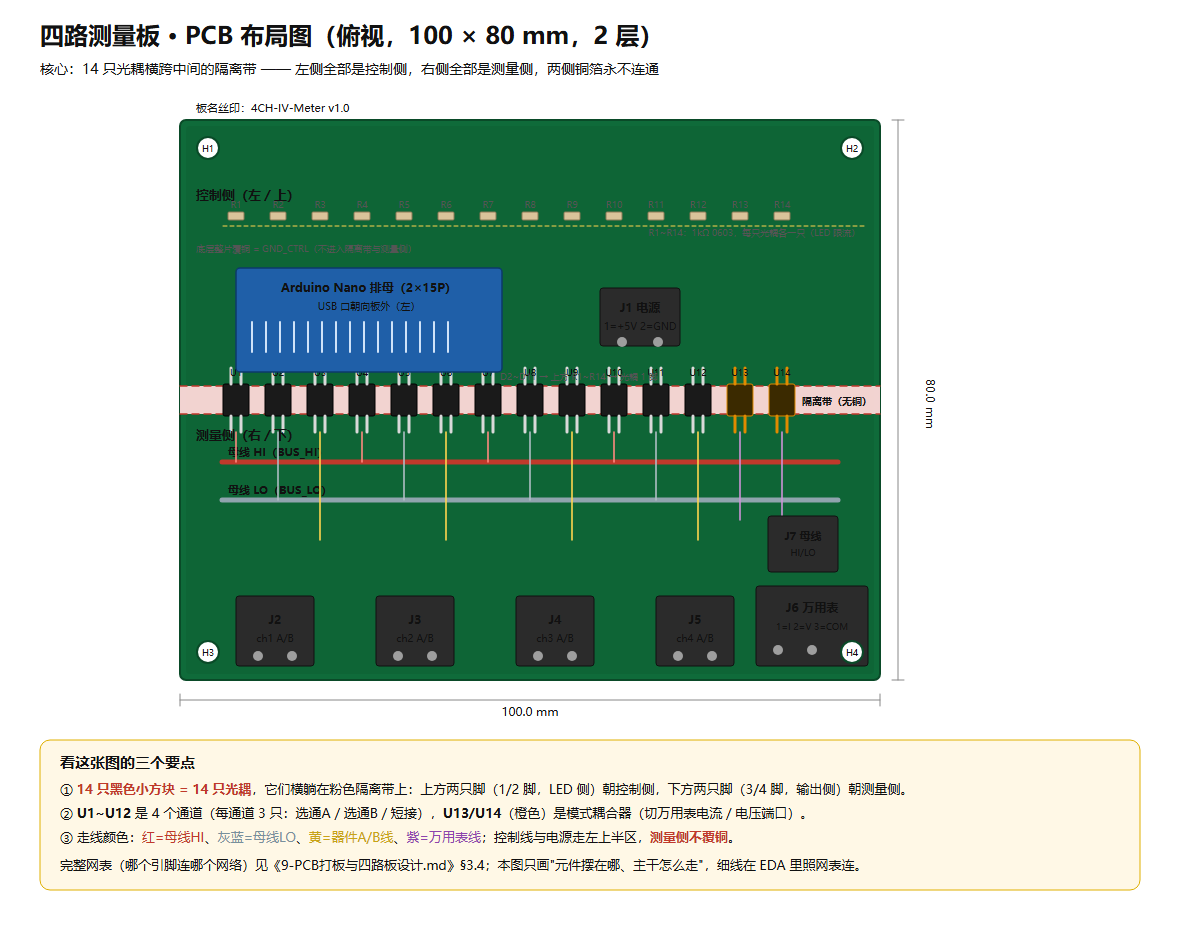
10-四路板PCB布局图.png
