guilinbai/iv-measurement/4-采购清单.md

# 采购清单（文件四）

> 需求依据见《1-测试系统目的与设计.md》。**继电器/开关部分预算 ≤1000 元**，本清单两套方案合计约 **465~705 元** ✓
> 分两个模式：**A. 面包板方案（4 路原型，零焊接）**、**B. 贴片方案（16 路正式板，嘉立创 SMT 代贴）**

---

## 0. 关键元件参数对比（选型依据）

| 型号 | 封装 / 端子 | 负载 | 导通电阻 | **关断漏电 max** | LED 驱动电流 | 适用 |
|---|---|---|---|---|---|---|
| **AQY212EH**（Panasonic） | DIP-4 / **直插** | 60 V / 0.55 A | 0.85 Ω typ（2.5 Ω max） | **1 µA** | 1.2 mA typ / 3 mA max | ✅ **面包板首选** |
| **AQY221R2V**（Panasonic） | SOP-4 / 贴片 | 40 V 级 | 低 | **nA 级** | 以手册为准 | ✅ **正式板首选** |
| AQY272（Panasonic） | DIP-4 / 直插 | 60 V / 1.8 A | 0.18 Ω 级 | 10 µA | ~3 mA | ⚠️ 仅验证逻辑 / mA 级器件 |
| AQY210EH（Panasonic） | DIP-4 / 直插 | 350 V / 0.13 A | 18 Ω typ | 1 µA | 1.2 mA | 不需要（高压版） |
| G3VM-61A1（Omron） | DIP-4 / 直插 | 60 V / 0.5 A | 2 Ω | µA 级 | — | 替代品 |
| TLP222A（Toshiba） | DIP-4 / 直插 | 60 V / 0.5 A | 2 Ω | µA 级 | — | 替代品 |
| 干簧继电器 | DIP/SIL / 直插 | — | — | pA 级（绝缘 >10¹² Ω） | — | 极致指标（有轻微机械声） |

**漏电门槛**（针对 Voc 100 mV / Isc 10 µA 的小信号器件）：
- **门槛 ≤1 µA @60 V**（关断电阻 ≥60 MΩ）→ AQY212EH 刚好达标（误差约 0.125%）
- **推荐 ≤100 nA**（关断电阻 ≥600 MΩ，留 10 倍余量）→ AQY221R2V 满足
- AQY272（10 µA ⇒ 6 MΩ）误差放大 10 倍，**不用于小信号正式测量**

---

## A. 面包板方案（4 路原型 · 零焊接 · 先跑通流程）

| 项 | 型号 / 规格 | 封装 | 数量 | 单价约 | 小计 | 采购关键词 |
|---|---|---|---|---|---|---|
| 开关 | **AQY212EH**（常开 PhotoMOS，60 V/0.55 A，漏电 max 1 µA） | **DIP-4 直插** | **14**（4 路 × 3 只 + 2 只模式耦合器） | 4~6 元 | 56~84 元 | `AQY212EH`（**无 A 后缀**） |
| 限流电阻 | 1 kΩ 1/4 W 金属膜（**每只光耦 LED 各串一只**） | 直插 | 14 | ~0.1 元 | ~1.4 元 | `1K 1/4W 金属膜电阻` |
| MCU | Arduino Nano 兼容板：**ATmega328P + CH340G**、**Type-C 口**、**必须已焊排针**（才能插面包板）+ 数据线 | 开发板 | 1 | 15~20 元 | 15~20 元 | `Arduino Nano CH340 Type-C 已焊排针` |
| 面包板 | 830 孔（**建议 3 块**：板1 Nano、板2 光耦区、板3 测量侧，控制地与母线 LO 物理分开） | — | 3 | 8~15 元 | 24~45 元 | `面包板 830孔` |
| 电源 | MB102 面包板电源模块 + 5 V/1 A 适配器 | — | 1 套 | ~15 元 | ~15 元 | `MB102 面包板电源模块` |
| 杜邦线 | 公对公 + 公对母 | — | 各 40 根 | ~10 元 | ~10 元 | `杜邦线 公对公 40P` |
| 器件端子 | **KF301-2P 螺钉端子**（每通道 1 个，接被测器件的 A/B 两端） | 直插 | 4 | ~1 元 | ~4 元 | `KF301-2P 5.08mm` |
| 万用表转接 | 香蕉插头转鳄鱼夹 / 转端子 | — | 2 | ~5 元 | ~10 元 | `香蕉插头转鳄鱼夹` |
| **小计** | | | | | **约 120~190 元** | |

> **接线照做即可**：14 只光耦的编号（光耦-1 ~ 光耦-14）与每只引脚接到哪里，见《5-面包板排线教程.md》第 3 节的完整总表。

> **KF301-2P 端子是干嘛的**：接被测器件用的接线柱，外观是绿色小塑料块 + 两颗螺丝，背面两根金属针（间距 5.08mm，正好等于面包板 2 个孔位，可直接插）。
> **用法**：器件 A 端线剥皮插左边孔、B 端线插右边孔，拧紧螺丝压住——**不需要焊接**。
> **为什么要 4 个**：每通道一个，① 你不会焊接，这是唯一不焊的接法；② 器件要换（扩路/换样品）时拧松螺丝即可；③ 螺钉压紧比面包板簧片可靠，适合 7 天连续运行；④ A/B 分左右两孔，防插错。
> **能不能省**：能（器件线直接插面包板，或焊到板上），但前者接触会松会氧化、后者要动烙铁，所以建议保留——4 元换"换器件自由 + 长期接触可靠"。

**引脚分配**：
- **4 路原型（Nano 直驱，每通道 2 位：选通位同时驱动 A、B 两只光耦）**：`D2`=ch1 选通 · `D3`=ch1 短接 · `D4`=ch2 选通 · `D5`=ch2 短接 · `D6`=ch3 选通 · `D7`=ch3 短接 · `D8`=ch4 选通 · `D9`=ch4 短接 · `D10`=模式耦合器·电流 · `D11`=模式耦合器·电压 → 共 **10 个数字输出**，无需 595（完整引脚表见《5-面包板排线教程.md》§4）
- **16 路正式板（74HC595 链）**：`D10`=DS 数据 · `D11`=SHCP 移位时钟 · `D12`=STCP 锁存 → **只用 3 个引脚**（32 位 = 4 片级联）；`A4/A5` 留给温度(I2C)、`D0/D1` 留给串口
- ⚠️ `A6/A7` **只能作模拟输入**，不能作数字输出，**不可用于驱动光耦**

**面包板注意**：
- 光耦 LED 端：1 脚 = 阳极（经 1 kΩ 接引脚）、2 脚 = 阴极（接控制侧 GND）；3/4 脚 = 输出（无极性）
- 测量侧（器件 + 母线 + DMM）与**控制侧地分开接**，不要共用一根地线（真实系统靠光耦隔离；面包板上至少分区布线）

---

## B. 贴片方案（16 路正式板 · 嘉立创 PCB + SMT 代贴 · 零焊接）

| 项 | 型号 / 规格 | 封装 | 数量 | 单价约 | 小计 | 采购关键词 |
|---|---|---|---|---|---|---|
| 开关 | **AQY221R2V**（常开 PhotoMOS，40 V 级，**漏电 nA 级**） | SOP-4 | **48**（16 路 × 3 只） | 4~6 元 | 192~288 元 | `AQY221R2V` |
| 移位寄存器 | 74HC595（32 位 = 4 片级联） | SOP-16 | 4 | ~1 元 | ~4 元 | `74HC595 SOP-16` |
| 限流电阻 | 1 kΩ（每只光耦 LED 一只） | 0603/0805 | 48 | ~0.05 元 | ~2.5 元 | `1K 0603 贴片电阻` |
| 去耦电容 | 100 nF | 0603 | 8 | ~0.05 元 | ~0.5 元 | `100nF 0603` |
| MCU 排母 | 1×30 双排母（Nano 直接插上，不焊） | 直插 | 2 | ~1 元 | ~2 元 | `1x30 圆孔排母` |
| 端子 | 5.08 mm 螺钉端子：器件 16×2P + 母线 1×2P + 电源 1×2P | 直插 | 34 | ~1 元 | ~34 元 | `5.08mm 螺钉端子 2P` |
| PCB | 嘉立创打样（≤10×10 cm，5 片） | — | 1 批 | 20~50 元 | 20~50 元 | `嘉立创 PCB 打样` |
| SMT 贴片 | 嘉立创基础贴片服务（含钢网、工程费） | — | 1 批 | 50~100 元 | 50~100 元 | `嘉立创 SMT 贴片` |
| 电源线材 | 5 V/1 A 适配器 + 24 AWG 双绞线 + 香蕉头/表笔线 | — | 1 套 | ~50 元 | ~50 元 | `5V1A 电源适配器` |
| **小计** | | | | | **约 355~530 元** | |

**另外建议（模式耦合器）**：DMM 的电流端口与电压端口之间，**推荐用一只 SPDT 光耦/继电器**（公共端接母线 HI、两掷位分别接电流/电压端口），物理上保证两个端口**不可能同时接通**；若用两只独立 SPST（如 AQY221R2V ×2，约 8~12 元），必须做固件互锁 + 硬件联锁。

---

## C. 预算总计

| 阶段 | 金额 |
|---|---|
| A. 面包板原型（4 路） | 约 105~165 元 |
| B. 正式 16 路板 | 约 355~530 元 |
| （可选）模式耦合器 | 8~12 元 |
| **合计** | **约 465~705 元 < 1000 元 ✓**（扩展到 24 路仍在预算内） |

---

## D. 采购陷阱（都踩过，务必看）

| # | 陷阱 | 说明 |
|---|---|---|
| 1 | **`AQY212EH` vs `AQY212EHA`** | 两者 Package 都标 **DIP4**，但 `EHA` / `EHAX` / `EHAZ` 的端子是**贴片鸥翼**，插不进面包板。**只有不带 A 后缀的 `EH` 是直插**。下单前看手册的 "Terminal Type"，不要只看 "Package" |
| 2 | **低漏电型号只有贴片** | nA 级漏电（RF/低 C×R 系列，如 AQY221R2V）为了做小寄生电容只能用 SSOP/SOP；**直插 DIP-4 的通用型是 µA 级（1 µA）**。所以：原型用 1 µA 直插（够用），正式板用 nA 级贴片 |
| 3 | **别按 datasheet 标称值直接比** | 漏电是在**额定电压（如 60 V）**下规定的。器件只工作在 100 mV 时，实际漏电要按 `R_off = 60 V ÷ I_leak` 折算（AQY272：10 µA ⇒ 6 MΩ ⇒ 100 mV 下仅 17 nA） |
| 4 | **不要买机械继电器模块** | 早期方案用"低电平触发继电器模块"已被淘汰：机械触点寿命短、有噪音、漏电与热电势不可控。**全系统统一用 PhotoMOS** |
| 5 | **杜邦线要买付数据线** | Arduino Nano 常见的"纯充电线"能供电不能传数据，是新手第一大坑 |
| 6 | **国产品牌可替代但需核对参数** | 群芯微、晶台等有 DIP-4 光耦继电器，价格更低，但**漏电指标要逐个核对手册**；本项目对漏电敏感，优先选参数标注明确的型号 |

**建议实测**：拿到光耦后，用 DMM6500 直接测关断漏电——器件两端加 **100 mV**、LED 不加电、电流档串在回路里读漏电。这是**你实际工作电压下**的真实漏电，比 datasheet 的 60 V 值更有决策价值。
