guilinbai/iv-measurement/(commit log)

2026-10-13 初始版本：4 路 IV 测量系统
    完成内容
    ========
    硬件设计
    - 被测器件通路设计（先断短接→再合选通→读数→先断选通→再合短接）
    - 面包板 4 路方案：14 只光耦 + 14 只 1kΩ，56 行接线总表
    - 四路 PCB 设计：板框/分区/完整网表/布线规则/丝印 + 布局图
    - 采购清单（面包板 ≈120~190 元 / SMD 板 ≈355~530 元）
    Arduino 固件 v1.1（arduino测试/12/12.ino）
    - S 命令：扫一轮 4 路 × (V+I) = 8 项，按模式分组，耦合器一轮只切 2 次
    - 每个读数窗口上报 WIN <通道> <V|I>，PC 收到立刻读表
    - 看门狗：10 秒无命令自动回安全态
    - 实测：一轮 1.59 s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
2026-10-13 新增：Git 版本管理零基础教程
2026-10-17 第一次尝试修改
2026-10-17 新增：GitHub 备份教程 + 一键配置脚本
2026-10-17 README：补充 setup_github.py 说明
2026-10-17 修复：万用表量程默认改为自动（锁死量程会超量程报错）+ 读数窗口 50->80ms
    - config.yaml: dmm_voltage/dmm_current 的 autorange 改为 true，固定 range 注释掉
    - ivcore/devices.py: 量程策略更严谨（auto 优先；只有 autorange=false 且给了 range 才设固定档）
    新增 warmup() 量程预热、_refresh_range() 读回确认、summary() 显示量程模式
    - main.py / ui/worker.py: 连接后自动预热 3 次，让自动量程先稳定
    - arduino测试/12/12.ino: T_WINDOW 50 -> 80 ms
    （实测读数 21~25 ms，但自动调零每 5 次会到 43 ms，自动量程切换时更慢）
    - 一轮耗时 1.56 -> 1.80 s；间隔 2 s 余量 0.20 s，建议 2.5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
    [12.ino, config.yaml, devices.py, main.py, main_window.py, scheduler.py, worker.py]
2026-10-21 第 3 期：温度采集（TA612）+ 电压源控制（Wanptek MODBUS-RTU）+ 第三个温度图
    新设备（均用真机验证）
    - TA612 温度采集器 @ COM4：9600 8N1，帧 55AA+指令+帧长+4通道+Sum，
    温度=原始值/10，校验=累加取低8位。实测 ch1=ch2=26.7℃，ch3/ch4=28000（未接探头，已过滤）
    - Wanptek 电压源 @ COM13：MODBUS-RTU，波特率 2400、从站地址 0（出厂默认）、
    数据小端、CRC16(0xA001)。实测 31V/5.2A。读 0x0002/0x0003 得电压电流，
    写 0x0001 设电压、写线圈 0x0000 开关输出
    （之前探测失败是因为用了 9600 bps + 地址 1，与默认值不符）
    新增模块
    - ivcore/tasensor.py TA612 协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
2026-10-21 清理：删除误放在项目根目录的 config.yaml（正确位置是 上位机/config.yaml）
2026-10-21 修复：电源写电压不通（必须一次写3个寄存器）+ 温度采集与测量严格同轮
    【问题1】点'应用'电源没反应
    根因：本设备固件要求 0x10 写寄存器时**必须一次写满 3 个**（start=0x0000, count=3）。
    写单个寄存器（count=1）设备完全不回应也不生效（实测 0x06 和 0x10 都不行）。
    另外数据段是小端（低字节在前）。
    修复：ivcore/powersupply.py 新增 _write3()：
    - 控制字/电压/电流一次写入（0x0000/0x0001/0x0002）
    - 控制字从状态寄存器推断（PS↔OUTCTRL, OS↔OCP）
    - 写后回读确认，不符就抛异常，界面能看到
    - 输出开关：本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
    [config.py, config.yaml, main_window.py, powersupply.py, scheduler.py, storage.py, worker.py]
2026-10-21 修复视图跨度失效 + 新增自定义小时视图 + 电源上限电流设置
    【问题1】视图的"1小时"等选项不起作用
    根因：_refresh 里"数据不足时自动贴合数据起点"的逻辑覆盖了用户选的跨度
    （刚启动只有 3 秒数据，把 600s/3600s 的视图压成 3 秒）。
    >2 小时的跨度走数据库分支，不受影响，所以表现为只有短跨度失效。
    修复：新增 _auto_fit 标志 —— 只有刚启动/自动模式才贴合数据起点；
    用户一旦明确选择跨度，就严格按所选跨度显示；
    数据铺满跨度后自动退出贴合模式。
    验证：8 种跨度全部精确（600/3600/86400/604800/1800/1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
    [main_window.py, powersupply.py, test_view_span.py]
2026-10-21 修复电源输出控制（端序陷阱）+ 修复滚轮缩放被重置
    ============================================================
    【问题1】点"输出开"电源不输出 —— 根因是端序，不是设备限制
    ============================================================
    协议 1.3 明确写着：状态寄存器0/1 **固定"高字节先"** 传输，
    不受"串口数据大小端设定"影响；而电压/电流等数据寄存器才用设定值（本机小端）。
    我之前把状态寄存器也按小端解析，导致：
    · 收到 00 01（高字节先）= 0x0001（PS=0，输出本来是关的）
    · 我读成 0x0100（PS=1，误以为输出已开）
    · 写控制字时也按小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
    [main_window.py, powersupply.py, test_zoom_keep.py]
2026-10-21 电源设定后增加'设定值vs实测值'校验提示（诊断出 2.99~3.06V 固件偏差区间）
2026-10-21 安全保护：关闭程序时自动关闭电源输出 + 温度超限自动断电
    【核心需求】关闭软件时关电源，防火
    - config: devices.powersupply.off_on_exit 默认改为 true
    - ui/main_window.closeEvent: 第一优先关电源输出
    · 连试 3 次
    · 兜底：直接写控制字 0x0000
    · 全部失败时明确警告"电源可能仍开启，请手动关闭或拔线"
    - 关闭流程最后再关一次（采集线程收尾期间可能有写入）
    【附加保护】温度超限自动断电
    - config 新增 safety 段：
    max_temp_c: 0 温度上限℃（0=不启用），超过自动关电源并报警
    on_stop_off: false 点停止采集时是否也关电源
    - u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
2026-10-21 修复 Y 轴缩放被刷新 + 缩放温度 Y 影响电信号图（同一根因）+ 布局改为左图右栏
    【问题1】滚动纵坐标(Y)时图表会自己刷新
    【问题2】滚动温度图的 Y 竟然影响电信号图
    两者是同一个根因：_refresh() 每帧都调用 self.plots.set_y_auto()，
    把三个图的 Y 轴强制重置为"自动缩放"，于是：
    · 用户手动缩放过的 Y 被立刻打回 -> 表现为"纵坐标滚轮缩放没用/自己刷新"
    · set_y_auto() 对三个图一起生效 -> 缩放温度 Y 时电信号图的 Y 也被重置
    -> 看起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
    [main_window.py, plots.py, test_y_zoom.py]
2026-10-22 改进：记忆界面设置 + 状态栏显示4路电压电流 + 温度并入电信号同一行
    【改进1】记忆功能：关闭后再打开保持上次设置
    新增 ui_state.json（在 上位机/ 目录，已加入 .gitignore）
    - 保存：采样间隔、视图跨度、自定义小时输入、电压源设定电压、
    上限电流、模拟模式、通道开关状态
    - closeEvent 时自动写入；启动时 _restore_state() 自动恢复并记日志
    "已恢复上次设置：间隔 3.00 s，视图 2.00 小时，电压 8.00 V"
    - 删掉该文件即恢复默认
    ====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
2026-10-22 修复：关闭 ch1 电学时温度 T1 也被隐藏（通道开关误把 T 一起关了）
    [plots.py]
2026-10-22 修复：滚轮缩放横坐标导致温度曲线消失（v0.4.0 的连带 bug）
    现象
    滚轮缩放 X 轴后，温度曲线变空。上一个版本没有这个问题。
    根因（两个）
    ① _refresh 里判断"是否用内存缓冲"的条件带了 follow：
    realtime = span_s <= 7200 and (self.follow or self.worker is None)
    手动缩放后 follow=False -> 强制走"数据库历史视图"分支。
    而历史视图取温度用的是 query_his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
    [buffer.py, main_window.py, test_zoom_temp.py]
2026-10-29 电源串口掉线自动恢复：重连 + 端口自动发现 + 健康检查
    日志报"电源连接失败"，拔插 USB 后恢复。
    经查是 CH340 USB 转串口掉线（Windows 长时间运行常见），
    报错原文：Cannot configure port ... 连接到系统上的设备没有发挥作用。
    改进
    ① PowerSupply.reconnect(max_try=3)
    关旧串口 → 重新 open()，带退避重试（0.4/0.8/1.2 s）。
    ② 端口自动发现 find_port(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
2026-10-29 改进电源状态显示：区分实测/设定、恒流提示；修输出按钮切反；串口偶发失败不误报
2026-10-29 电源状态显示改进 + 修输出按钮切反 + 通道开关不再记忆
    【用户报告的两个现象，先做了实测】
    1) "500mA 显示 120mA"
    2) "电源是开，显示却是关"
    实测（真机）：
    设定 0.500 A → 回读 0.5000 A [准确]
    3.00V/500mA 运行 → 实测 3.21V/112mA ← 112mA ≈ 用户看到的 120mA
    11V/500mA 运行 → 实测 7.02V/500mA 恒流 CC
    关输出后 → PS=0 [显示正确]
    结论：软件读数**是准的**。"112mA" 是**实测电流**（恒压 CV 模式下
    电压固定、电流完全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
2026-10-29 新增《数据存储说明.md》：完整描述数据结构与存储规则；并修跨天轮号错乱 bug
